SamarGrigoriy/simistor-regulator/images/01_плата_сверху.png

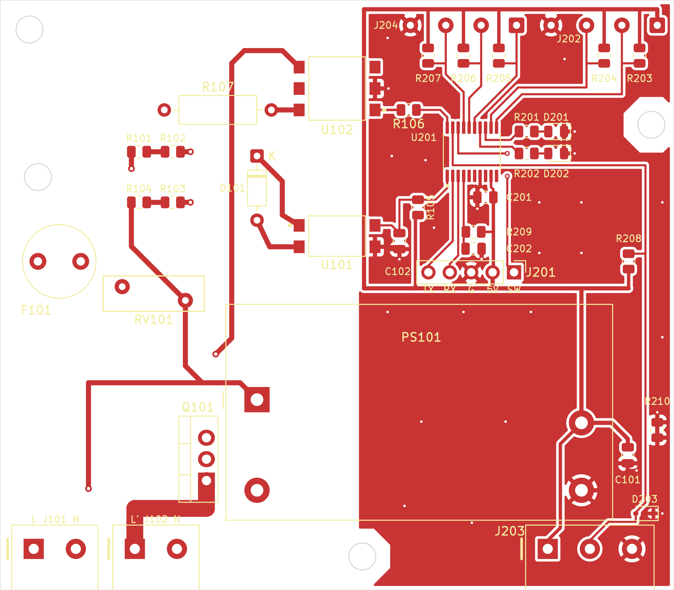
images/01_плата_сверху.png
