SamarGrigoriy/simistor-regulator/images/02_плата_снизу.png

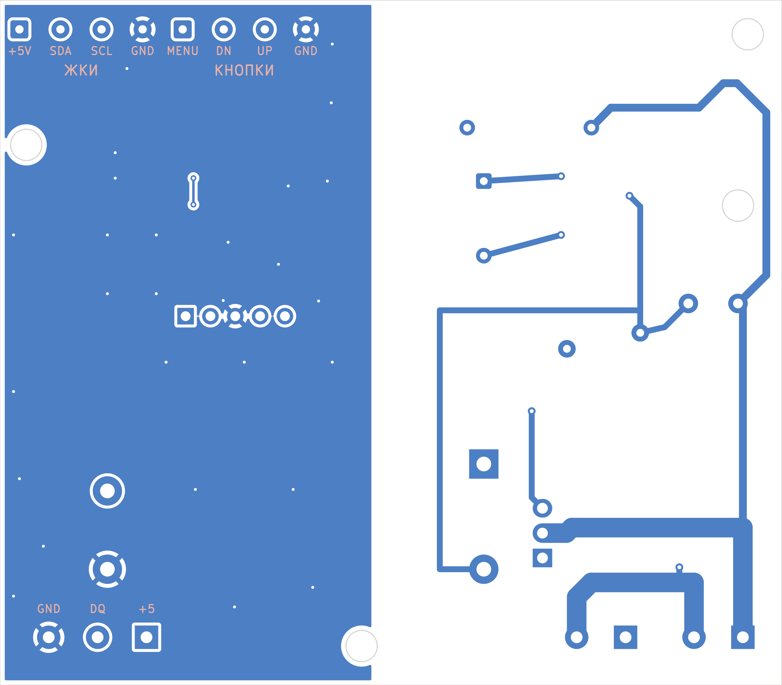
images/02_плата_снизу.png
