SamarGrigoriy/simistor-regulator/images/04_медь_B.png

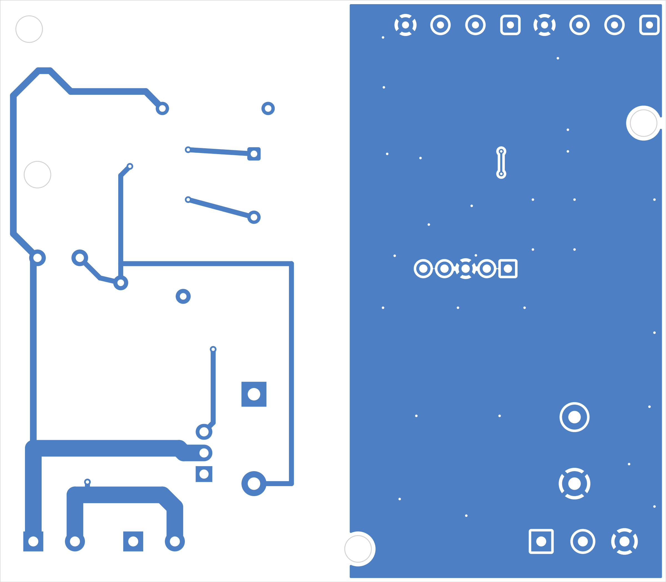
images/04_медь_B.png
