SamarGrigoriy/simistor-regulator/images/05_сборочный.png

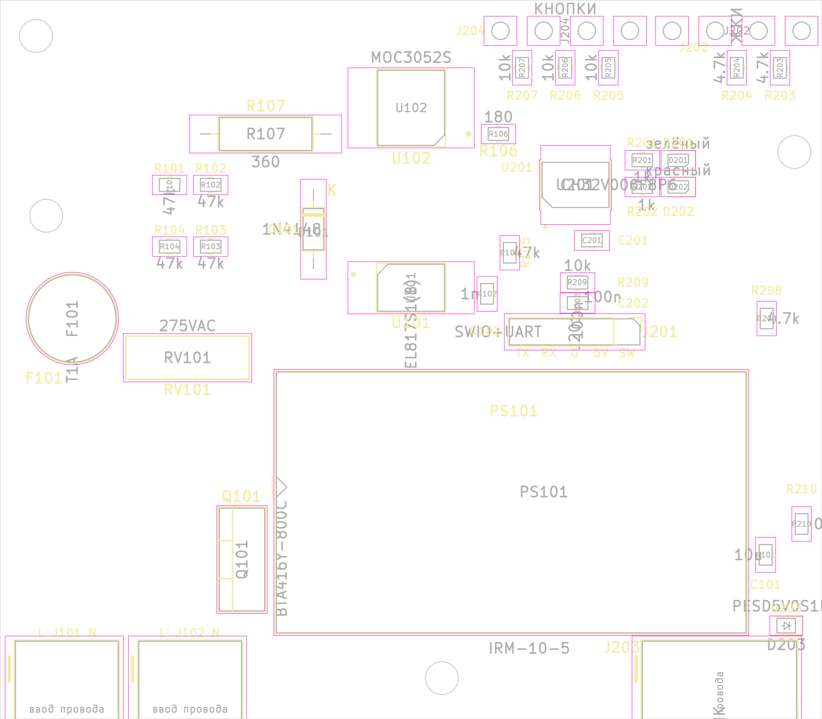
images/05_сборочный.png
