SamarGrigoriy/simistor-regulator/images/06_3d_сверху.png

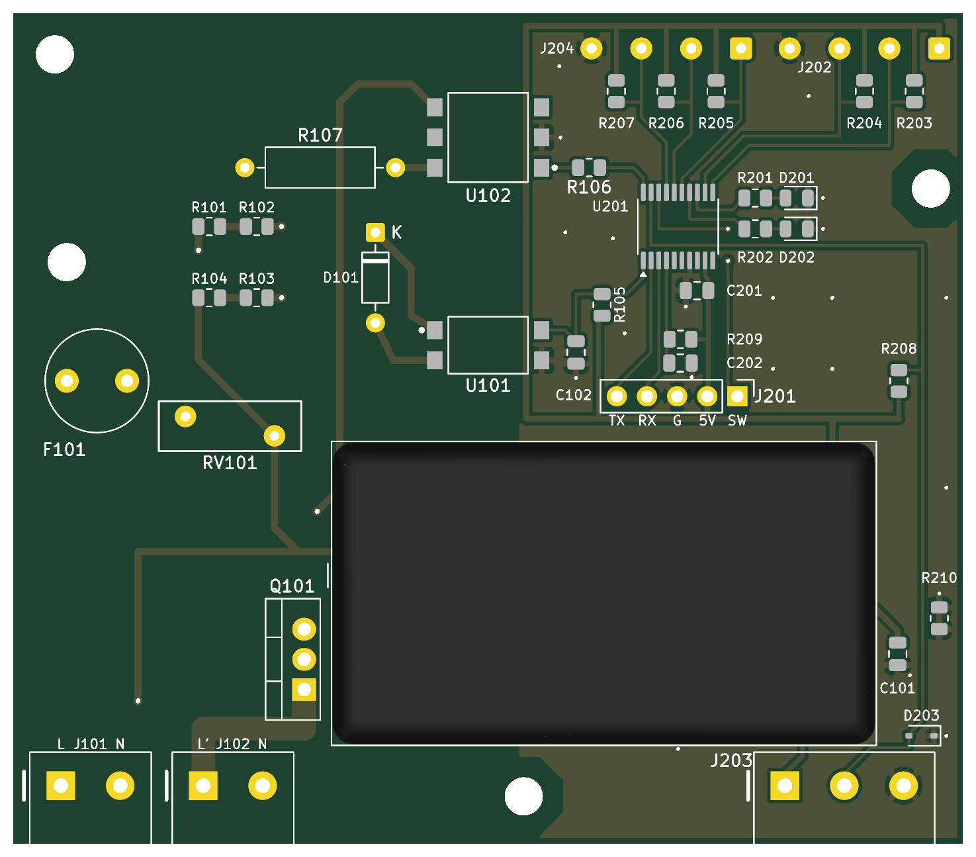
images/06_3d_сверху.png
