SamarGrigoriy/simistor-regulator/images/07_3d_изометрия.png

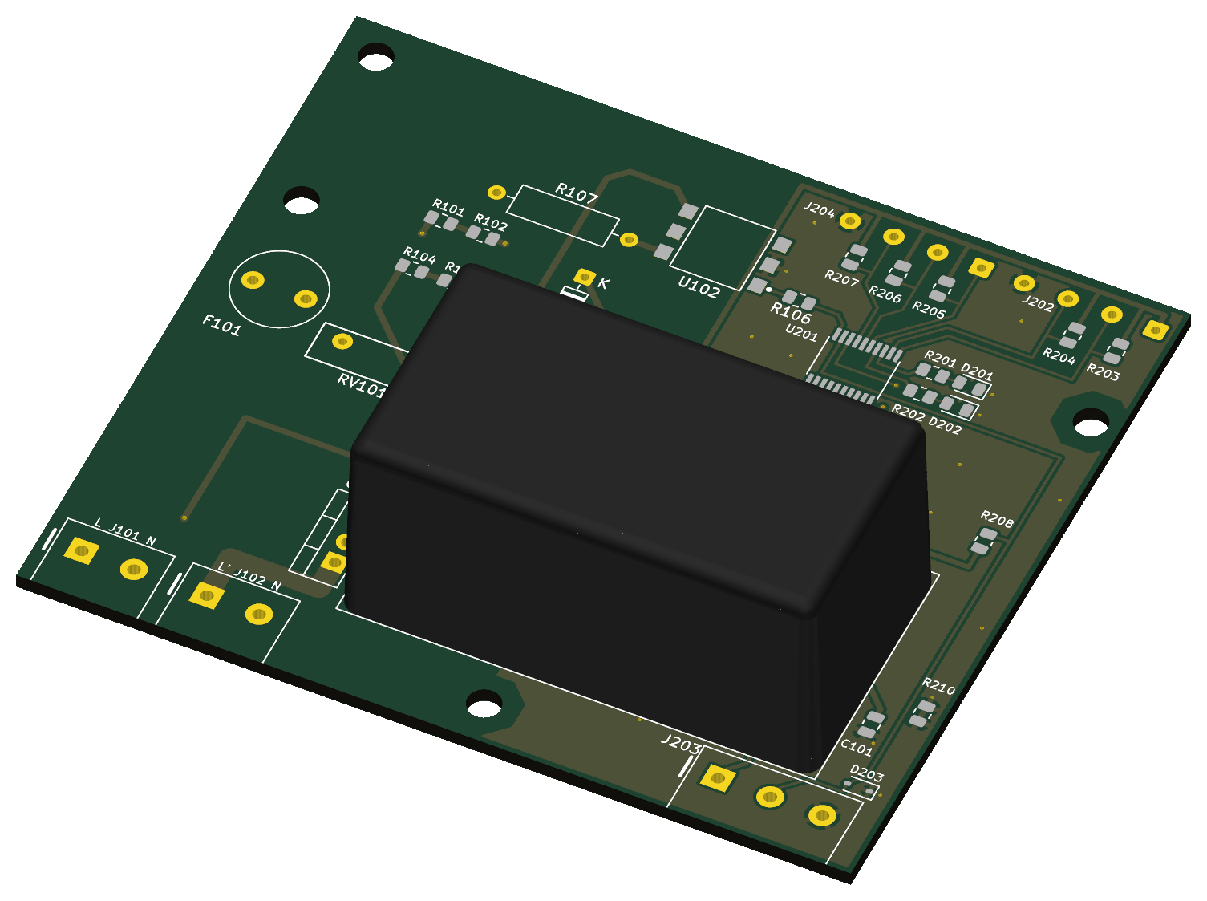
images/07_3d_изометрия.png
