SamarGrigoriy/simistor-regulator/images/08_3d_снизу.png

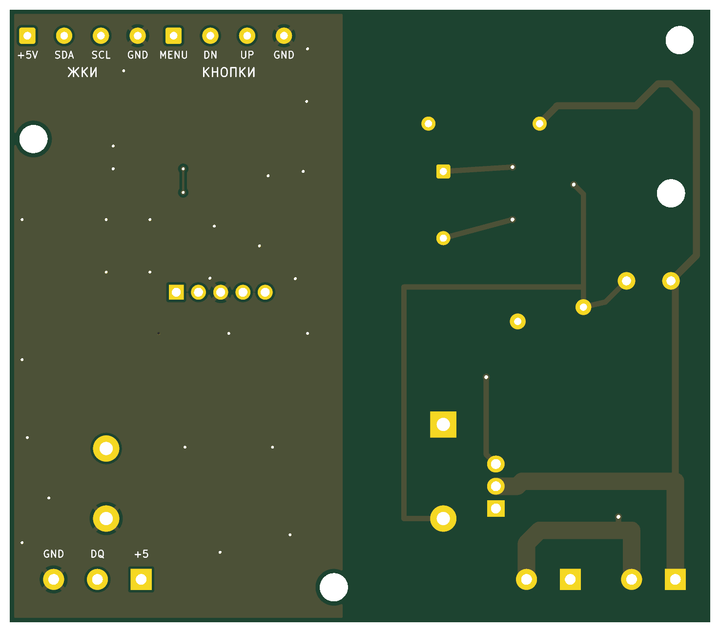
images/08_3d_снизу.png
