SamarGrigoriy/simistor-regulator/images/09_корпус.png

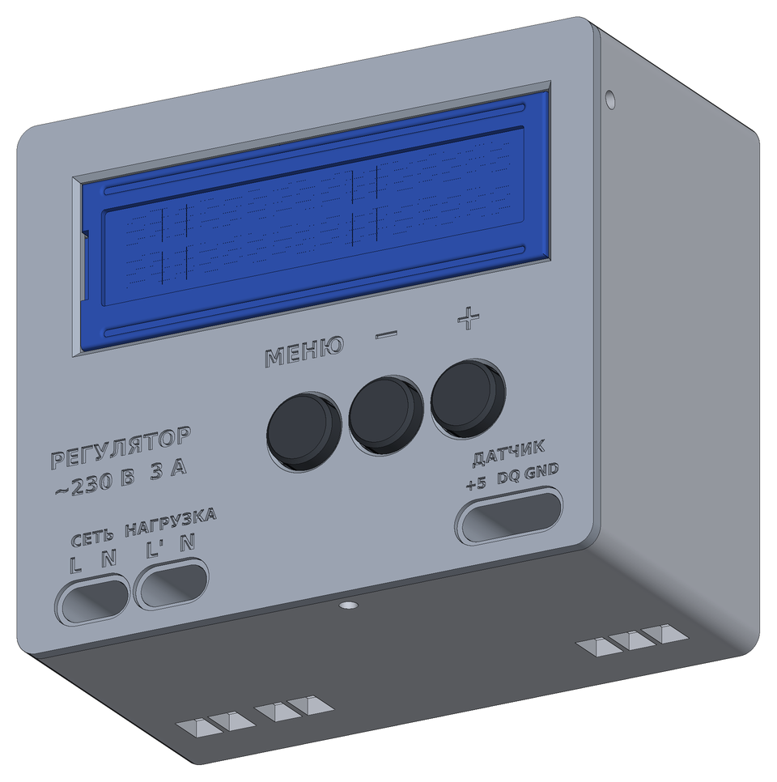
images/09_корпус.png
