SamarGrigoriy/simistor-regulator/images/10_корпус_лицо.png

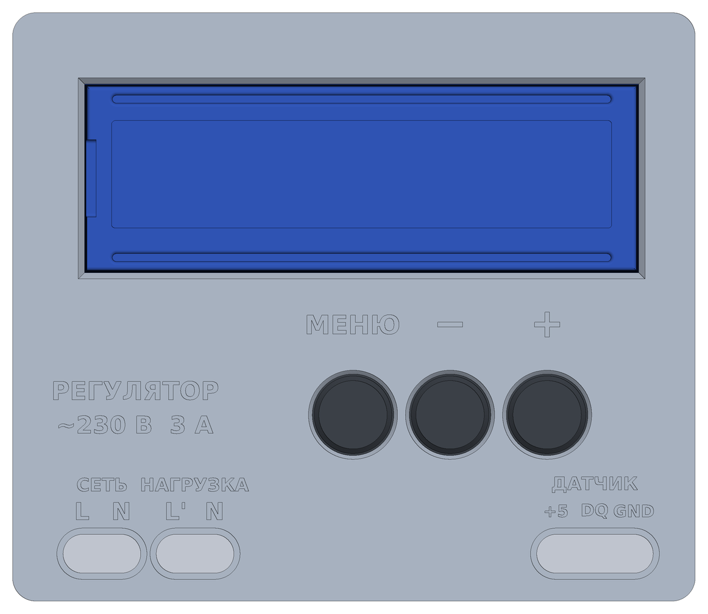
images/10_корпус_лицо.png
