SamarGrigoriy/simistor-regulator/images/11_корпус_сверху_слева.png

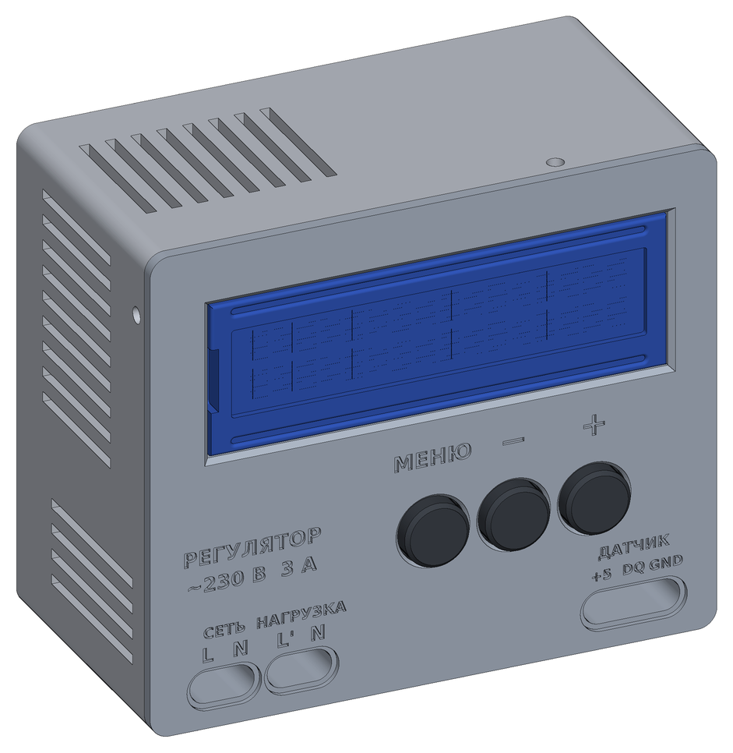
images/11_корпус_сверху_слева.png
