SamarGrigoriy/simistor-regulator/images/12_корпус_низ.png

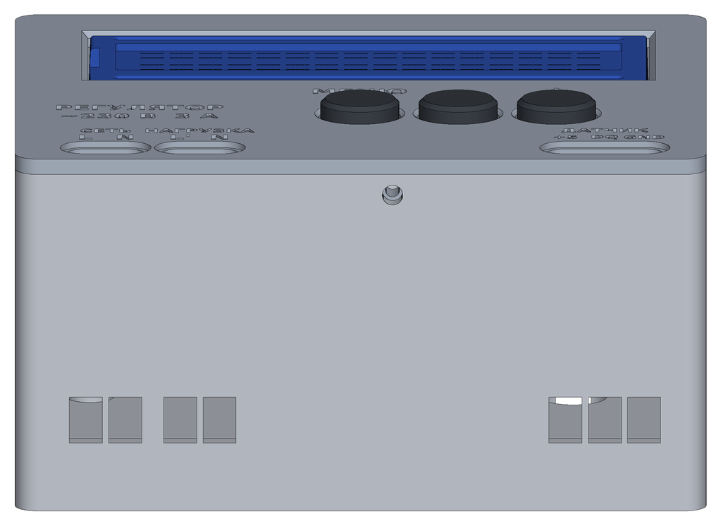
images/12_корпус_низ.png
