SamarGrigoriy/simistor-regulator/images/13_корпус_левая_стенка.png

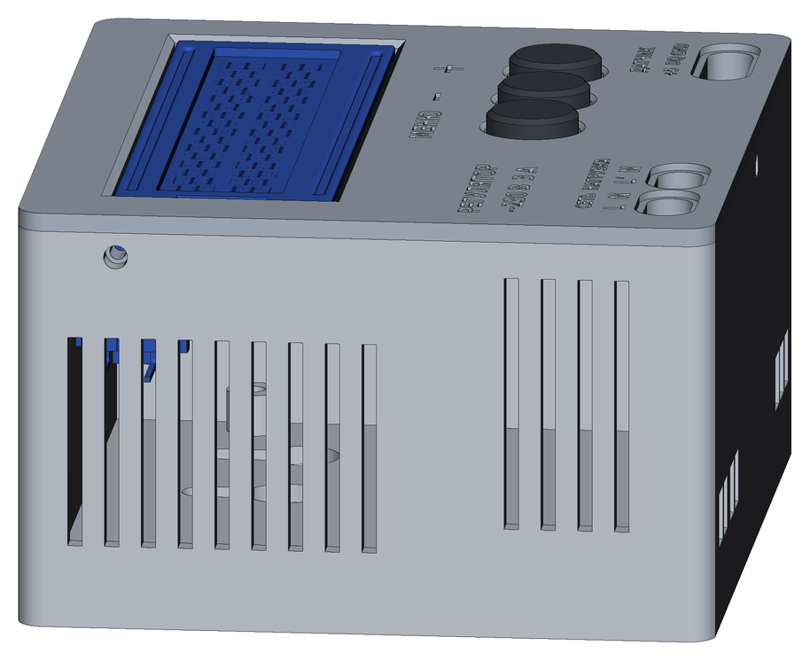
images/13_корпус_левая_стенка.png
