SamarGrigoriy/simistor-regulator/images/14_крышка_изнутри.png

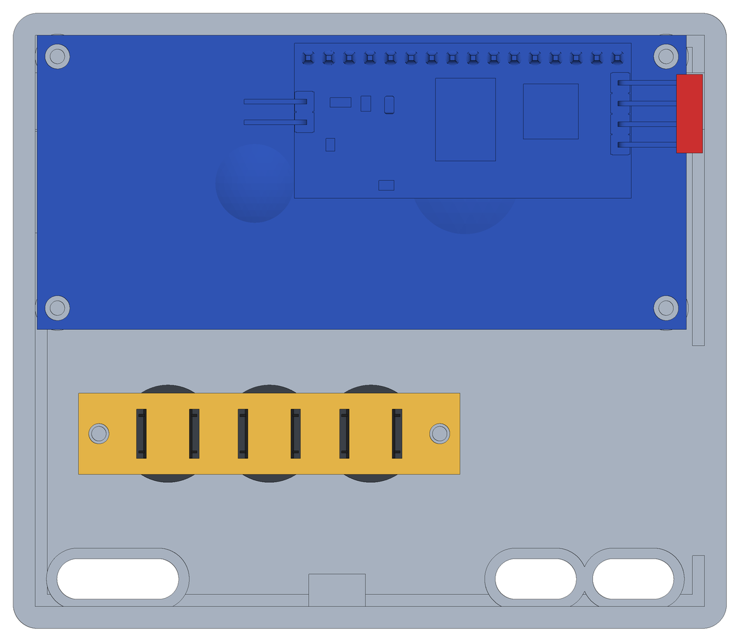
images/14_крышка_изнутри.png
