SamarGrigoriy/simistor-regulator/images/15_сборка_открыто.png

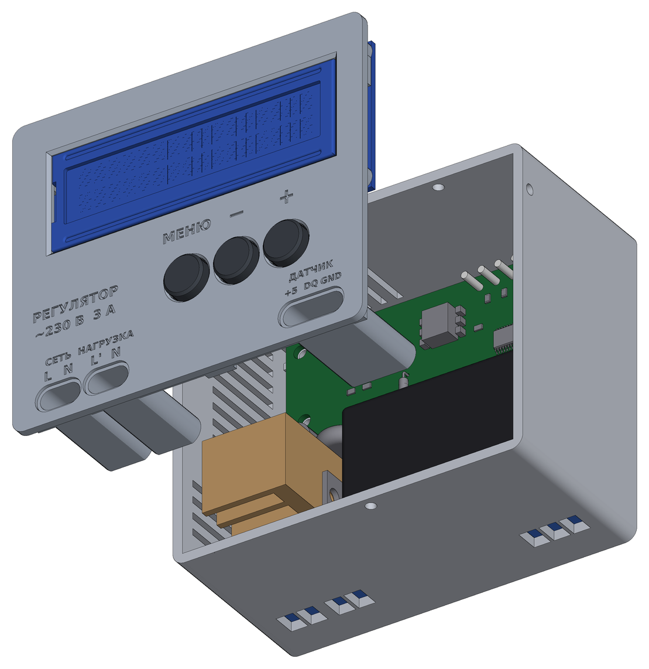
images/15_сборка_открыто.png
