SamarGrigoriy/simistor-regulator/images/16_сборка_внутри_сверху.png

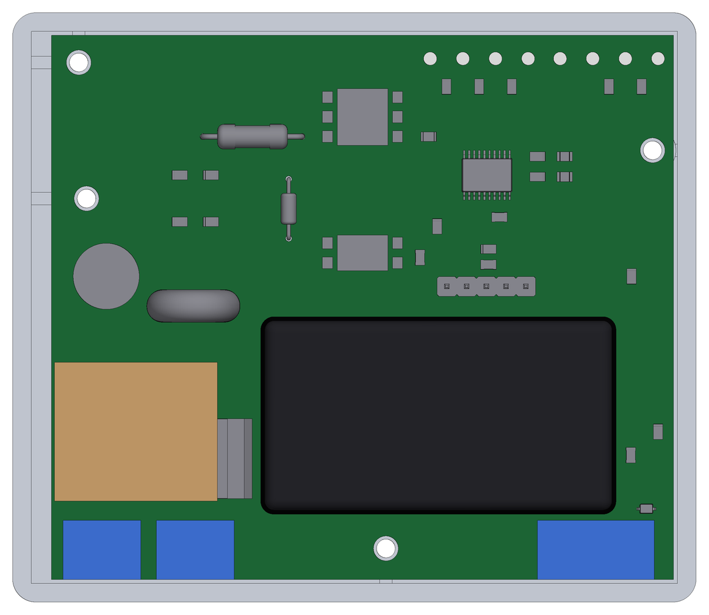
images/16_сборка_внутри_сверху.png
