SamarGrigoriy/simistor-regulator/images/17_сборка_внутри.png

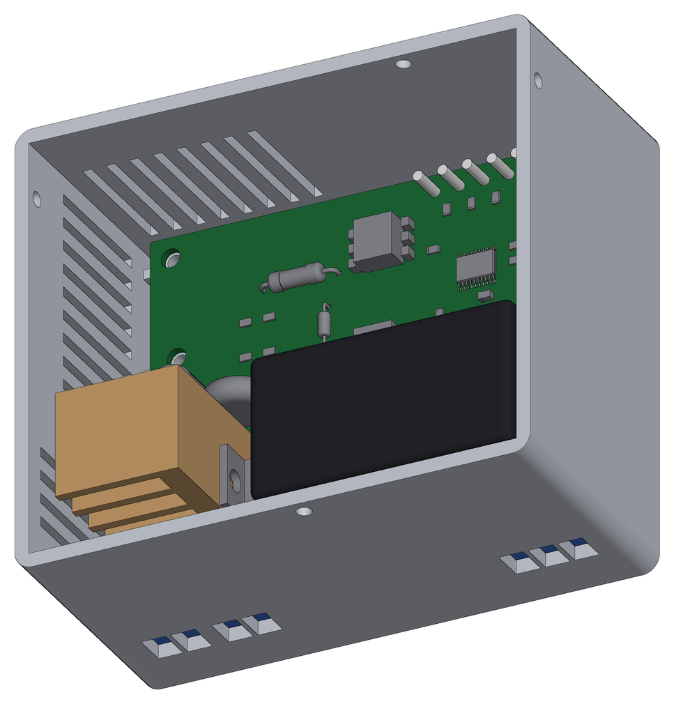
images/17_сборка_внутри.png
