SamarGrigoriy/simistor-regulator/images/18_взрыв_схема.png

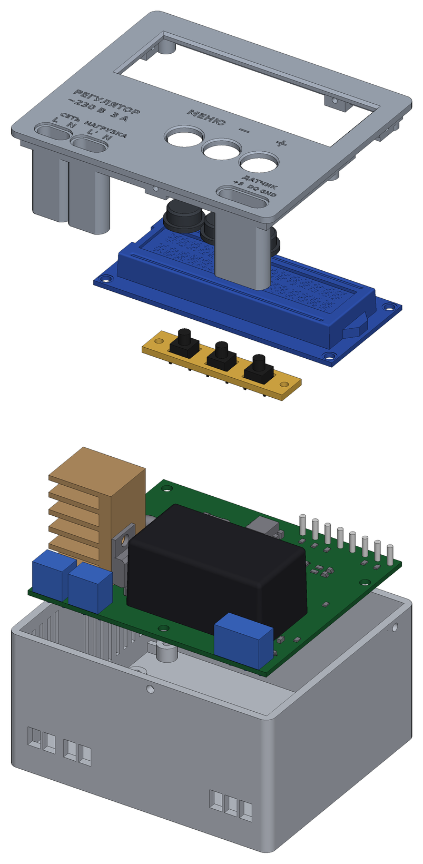
images/18_взрыв_схема.png
