SamarGrigoriy/simistor-regulator/images/19_разрез_ЖКИ.png

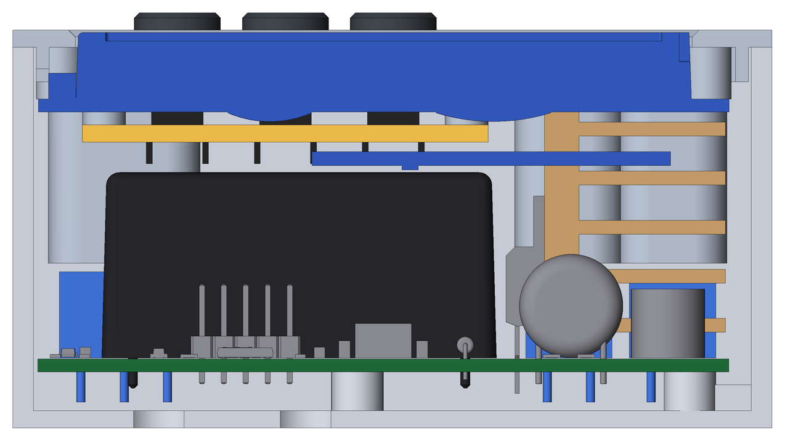
images/19_разрез_ЖКИ.png
