SamarGrigoriy/simistor-regulator/images/20_разрез_симистор.png

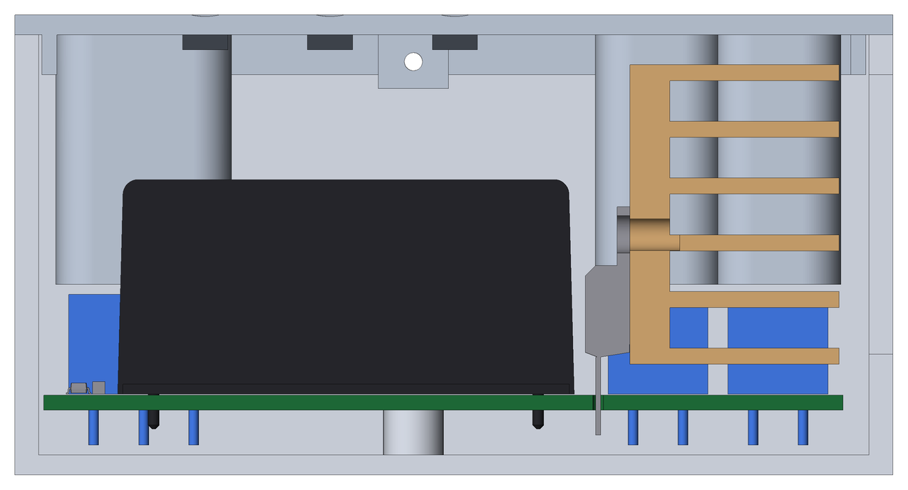
images/20_разрез_симистор.png
