SamarGrigoriy/simistor-regulator/images/src/3d_bottom.png

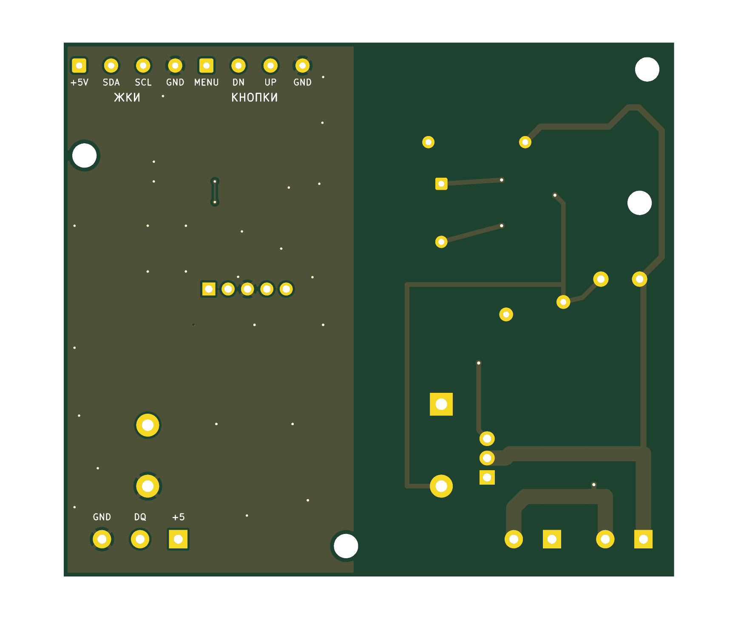
images/src/3d_bottom.png
