SamarGrigoriy/simistor-regulator/images/src/3d_iso.png

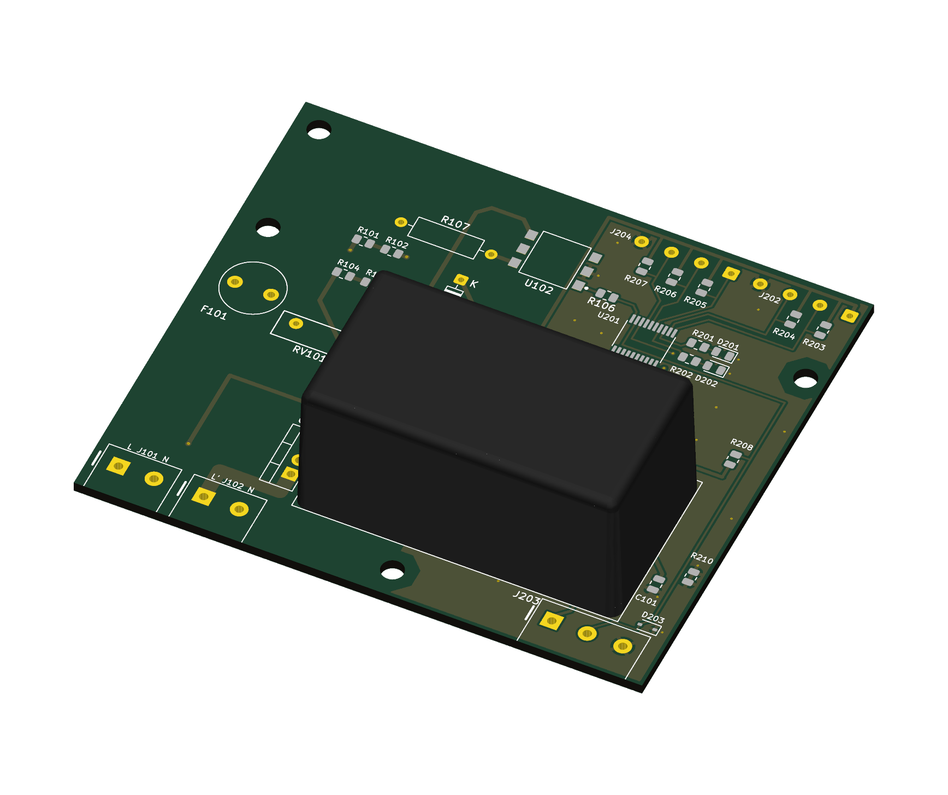
images/src/3d_iso.png
