SamarGrigoriy/simistor-regulator/images/src/3d_top.png

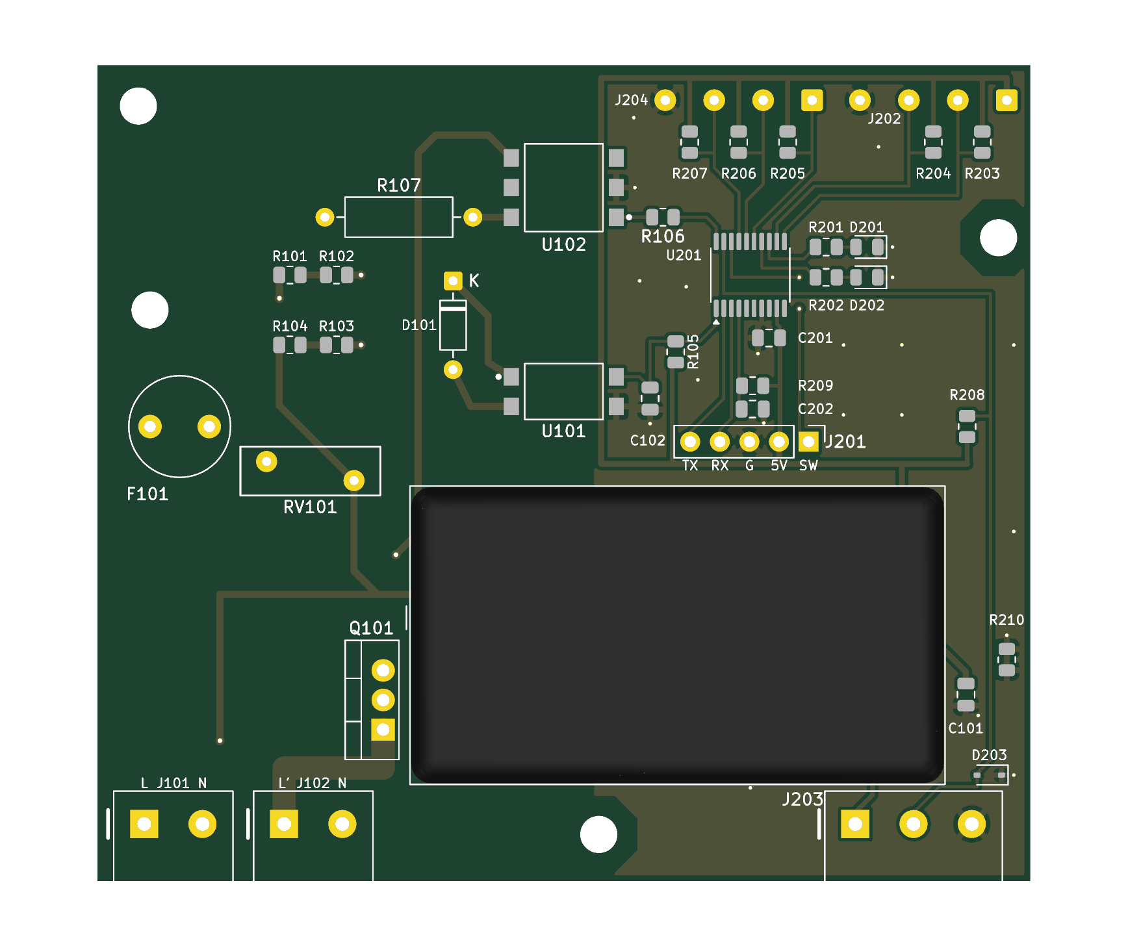
images/src/3d_top.png
