SamarGrigoriy/simistor-regulator/enclosure/build/assembly.step

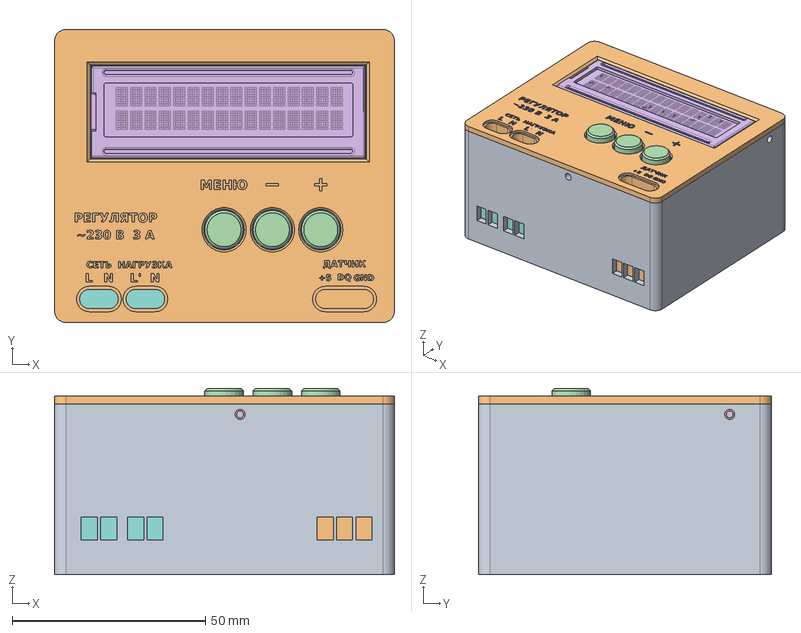
[picture p23: CAD file, 2026-10-23]
enclosure/build/assembly.step
87.9 x 75.8 x 48.1 mm
base
lid
button_holder
button_cap_1
button_cap_2
button_cap_3
heatsink
lcd_i2c
i2c_wires
switch_1
switch_2
switch_3
board
