SamarGrigoriy/simistor-regulator/enclosure/build/lid.stl

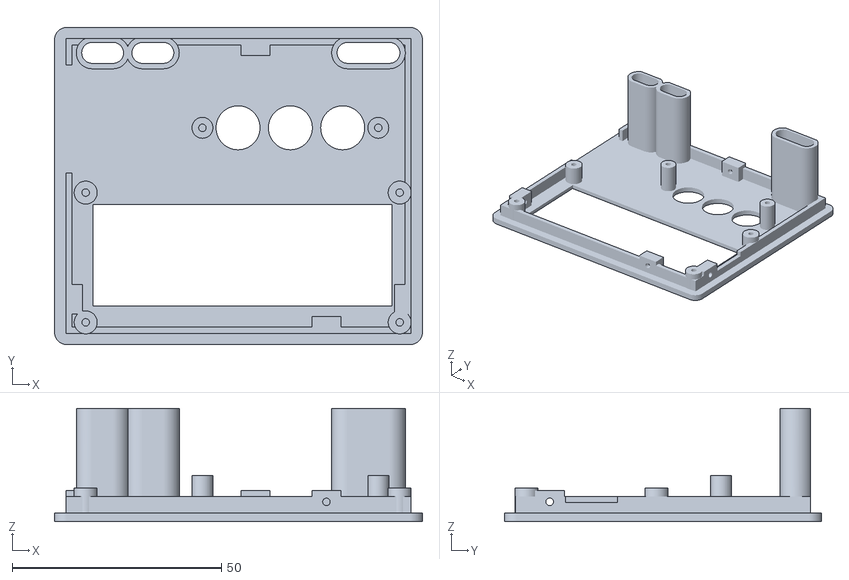
[picture p26: CAD file, 2026-10-23]
enclosure/build/lid.stl
87.9 x 75.8 x 27.0
