SamarGrigoriy/simistor-regulator/enclosure/build_4A/board.step

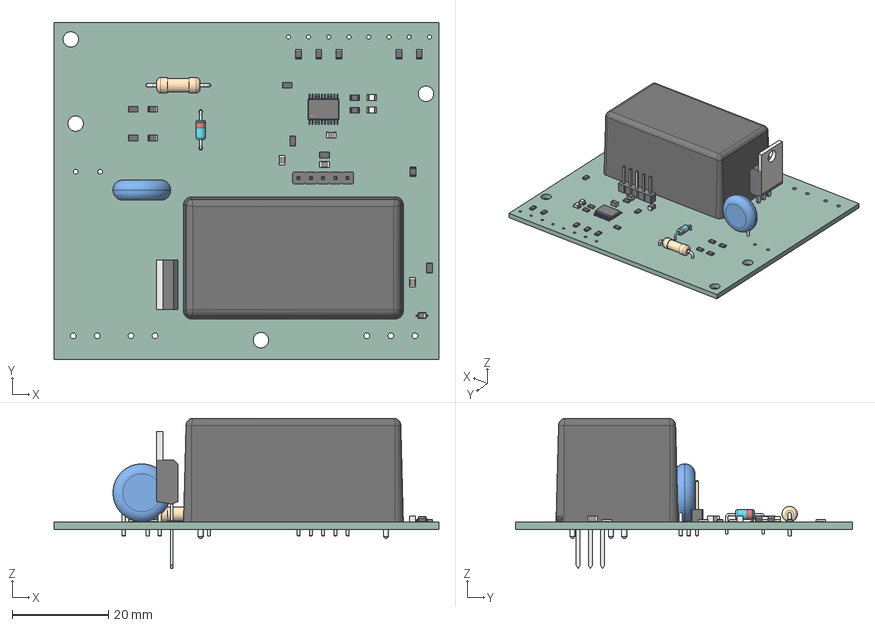
[picture p27: CAD file, 2026-10-23]
enclosure/build_4A/board.step
80.0 x 70.0 x 31.2 mm
R_0805_2012Metric x 16
C_0805_2012Metric x 4
LED_0805_2012Metric x 2
PinHeader_1x05_P254mm_Vertical
D_SOD-323
D_DO-35_SOD27_P7.62mm_Horizontal
TSSOP-20_4.4x6.5mm_P0.65mm
TO-220-3_Vertical
R_Axial_DIN0309_L90mm_D32mm_P1270mm_Horizontal
RV_Disc_D12mm_W42mm_P75mm
regulator1_PCB
