SamarGrigoriy/simistor-regulator/enclosure/models/LCD1602_I2C.step

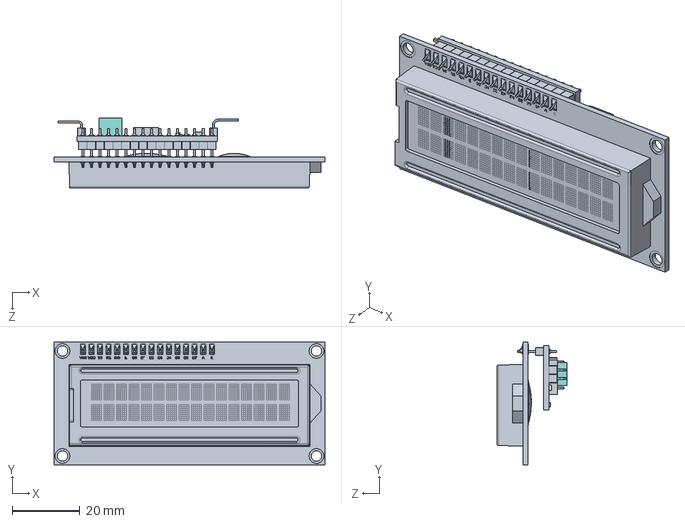
[picture p28: CAD file, 2026-10-23]
enclosure/models/LCD1602_I2C.step
80.0 x 36.3 x 20.8 mm
