SamarGrigoriy/simistor-regulator/enclosure/build/button_cap.stl

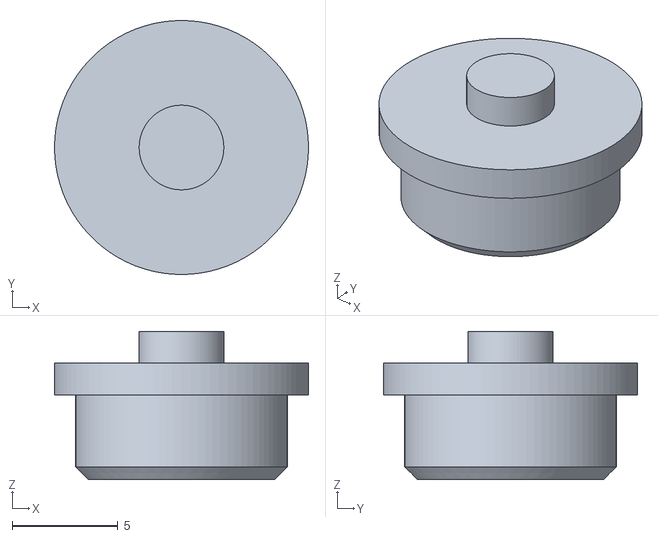
[picture p29: CAD file, 2026-10-23]
enclosure/build/button_cap.stl
12.0 x 12.0 x 7.00
