SamarGrigoriy/simistor-regulator/enclosure/build_4A/lid.stl

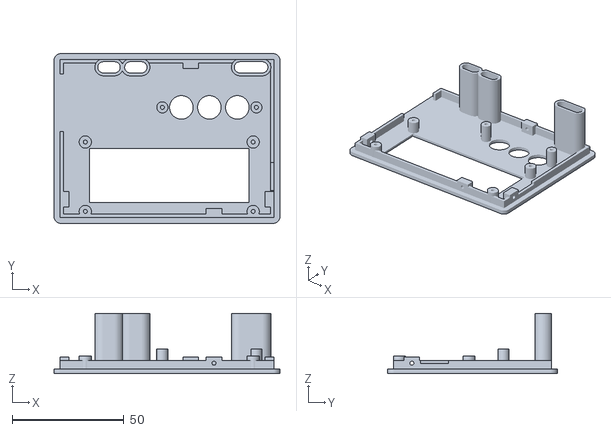
[picture p30: CAD file, 2026-10-23]
enclosure/build_4A/lid.stl
101.0 x 75.8 x 27.0
