SamarGrigoriy/simistor-regulator/enclosure/build/base.stl

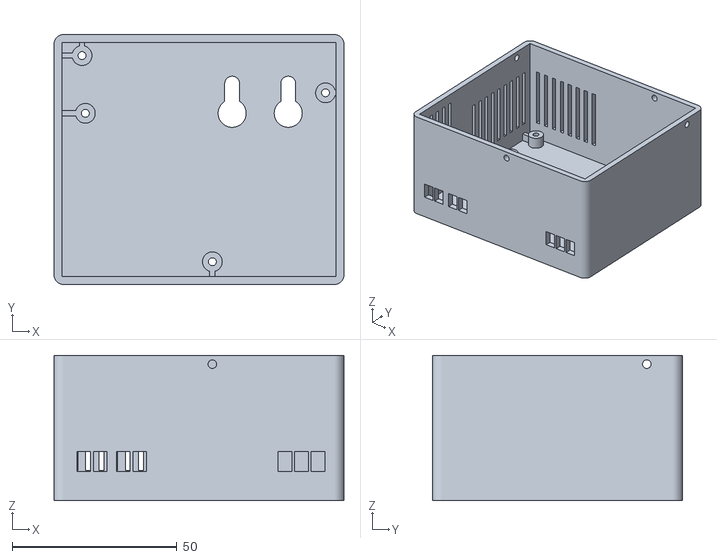
[picture p31: CAD file, 2026-10-23]
enclosure/build/base.stl
87.9 x 75.8 x 44.1
