SamarGrigoriy/simistor-regulator/enclosure/build_4A/button_holder.stl

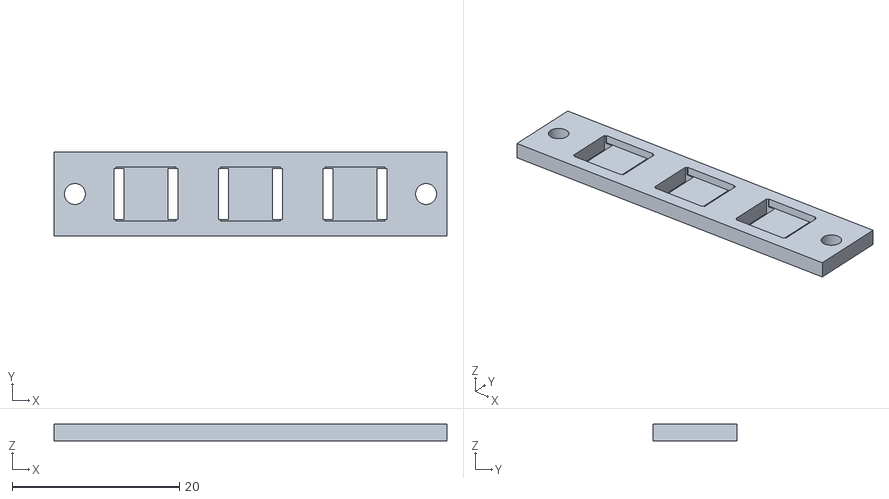
[picture p32: CAD file, 2026-10-23]
enclosure/build_4A/button_holder.stl
47.0 x 10.0 x 2.00
