SamarGrigoriy/simistor-regulator/enclosure/build_4A/case.step

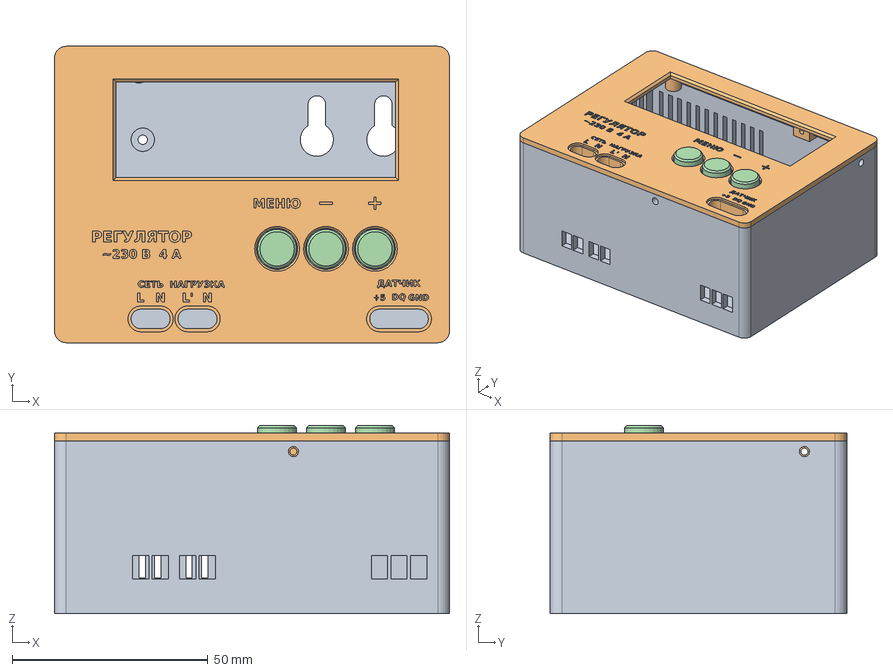
[picture p33: CAD file, 2026-10-23]
enclosure/build_4A/case.step
101.0 x 75.8 x 48.1 mm
base
lid
button_holder
button_cap_1
button_cap_2
button_cap_3
