SamarGrigoriy/simistor-regulator/enclosure/build_4A/base.stl

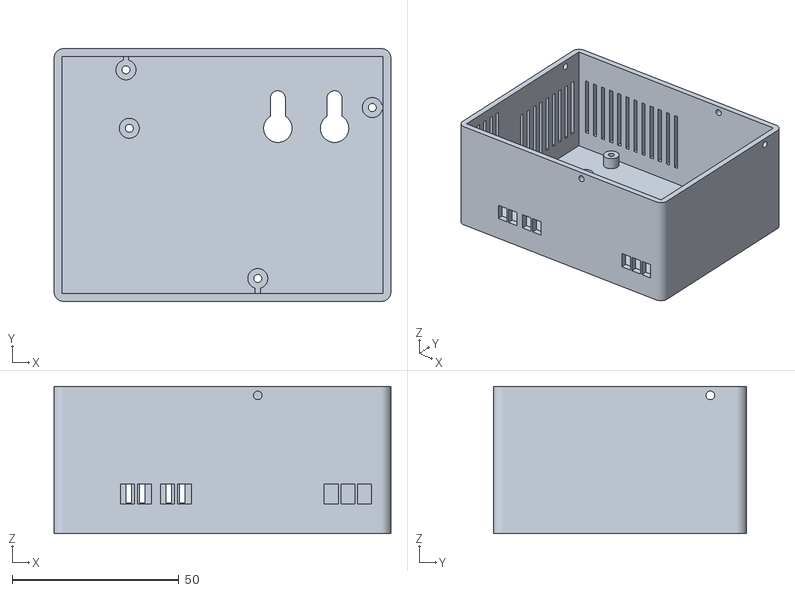
[picture p34: CAD file, 2026-10-23]
enclosure/build_4A/base.stl
101.0 x 75.8 x 44.1
