SamarGrigoriy/simistor-regulator/enclosure/build/case.step

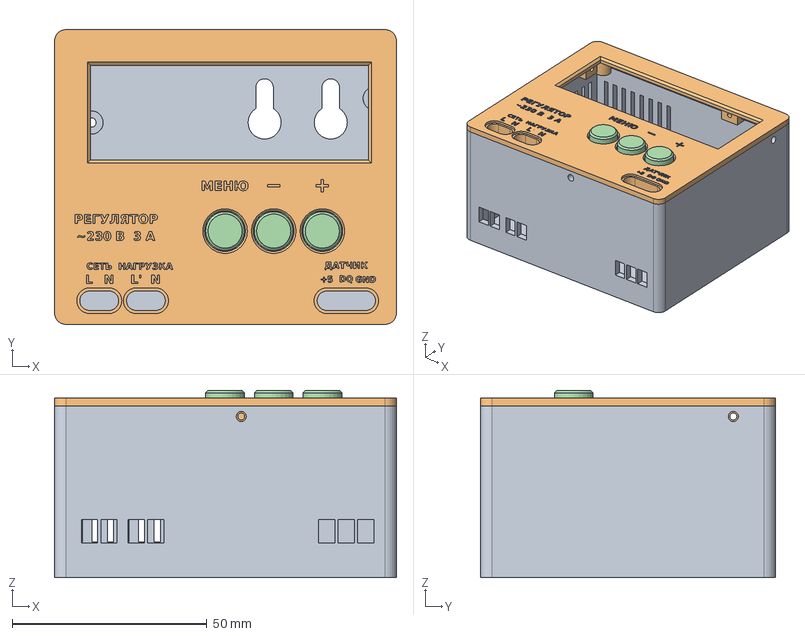
[picture p35: CAD file, 2026-10-23]
enclosure/build/case.step
87.9 x 75.8 x 48.1 mm
base
lid
button_holder
button_cap_1
button_cap_2
button_cap_3
