SamarGrigoriy/simistor-regulator/(list of files, cad)

Other CAD files:
enclosure/build/board.step
