SamarGrigoriy/simistor-regulator/build/3d_top.png

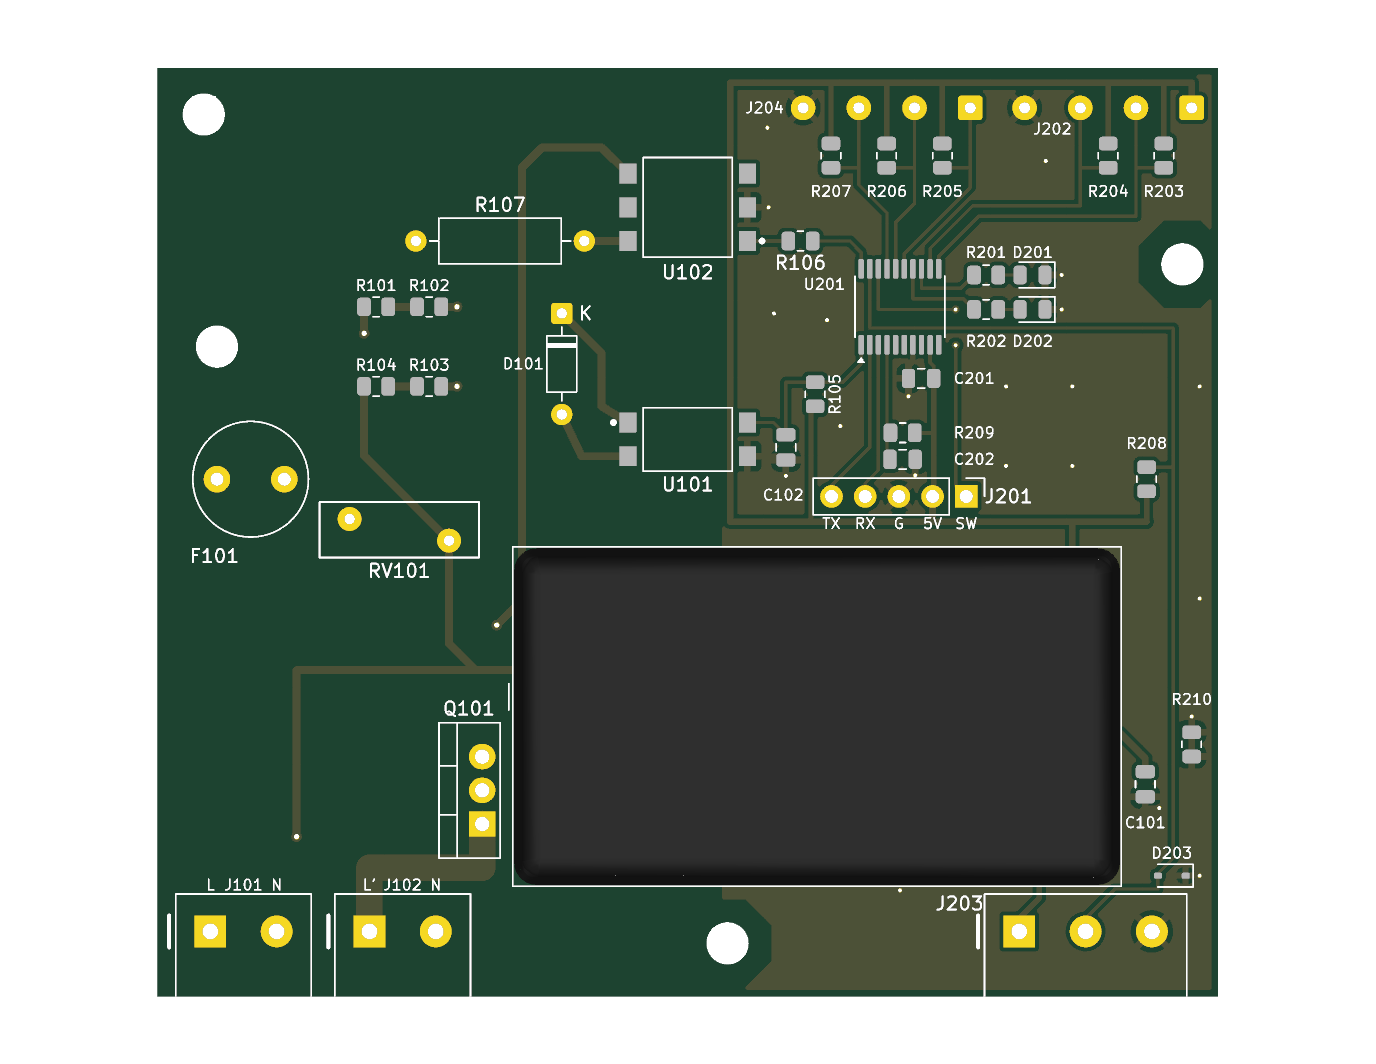
build/3d_top.png
