SamarGrigoriy/simistor-regulator/build/img/3d_bottom.png

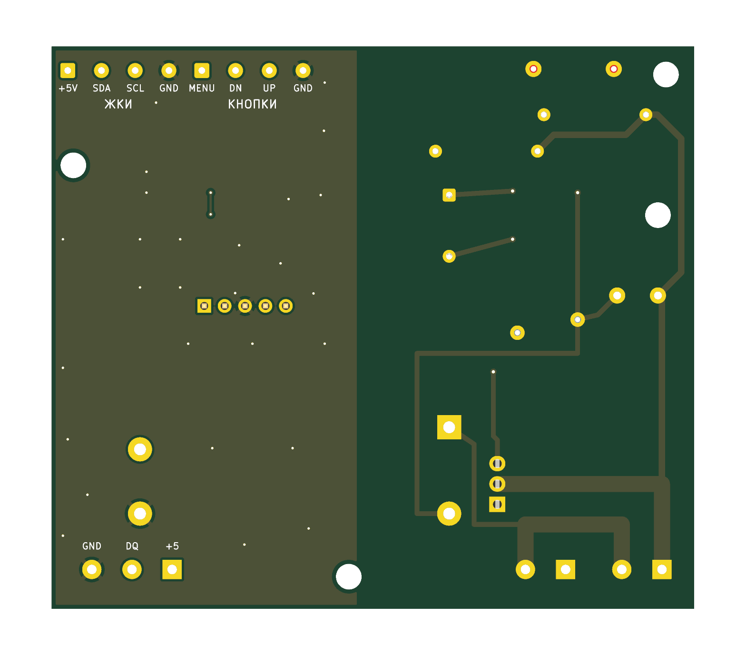
build/img/3d_bottom.png
