SamarGrigoriy/simistor-regulator/build/img/3d_iso.png

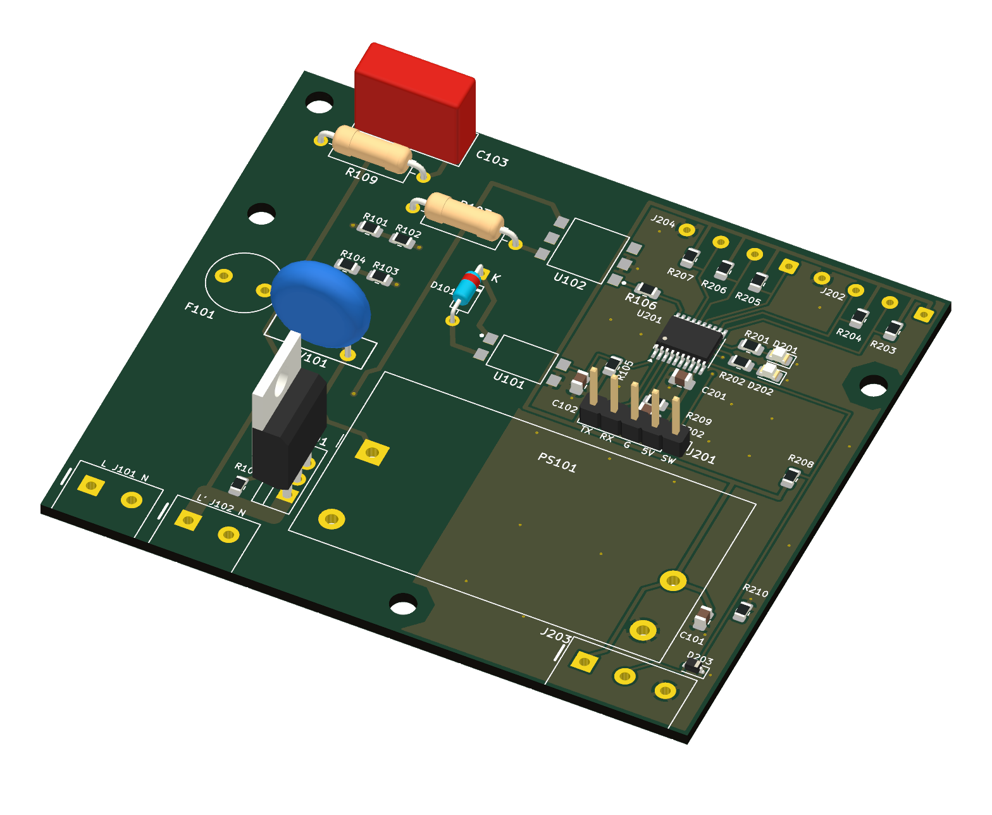
build/img/3d_iso.png
