SamarGrigoriy/simistor-regulator/build/img/3d_top.png

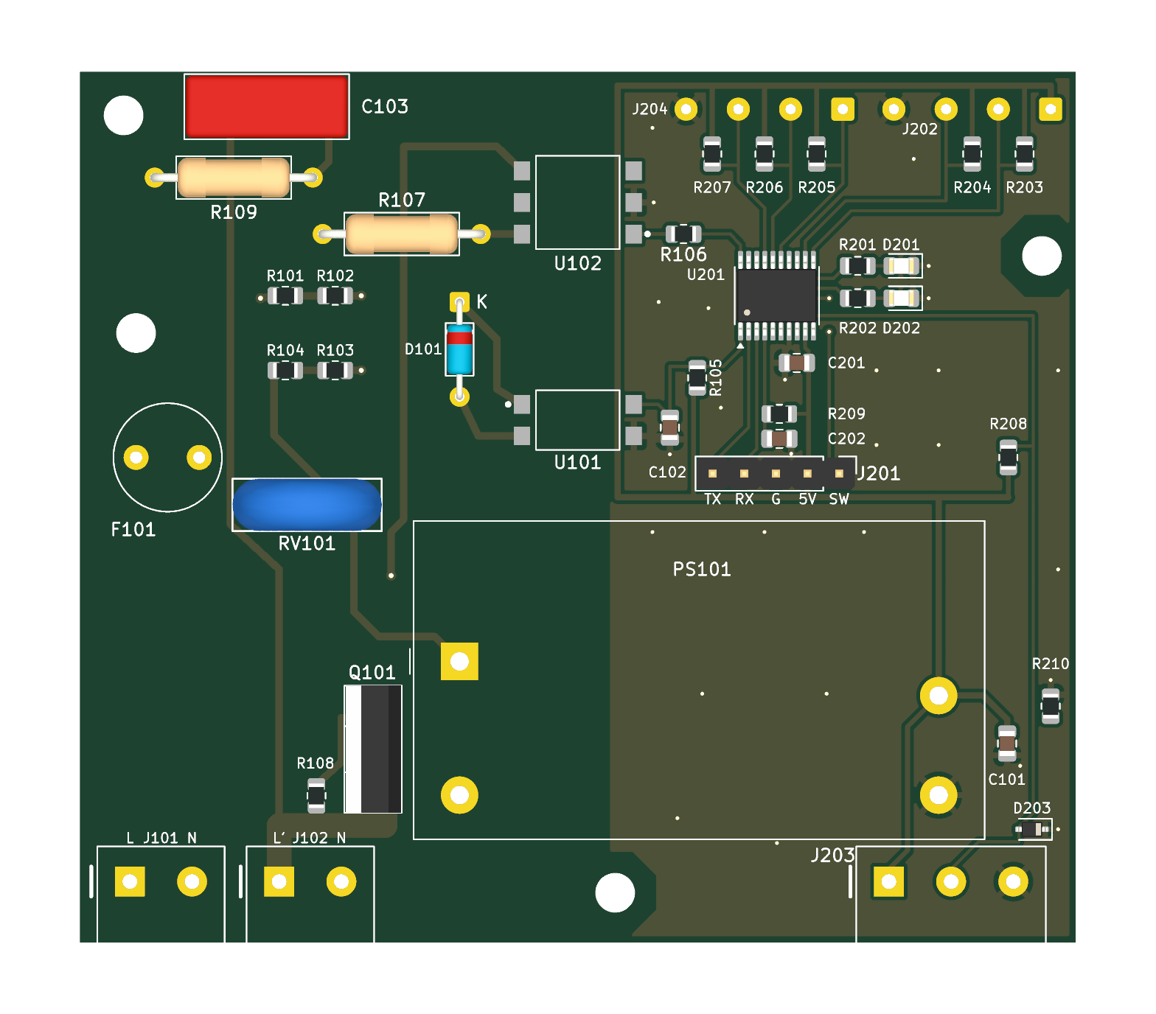
build/img/3d_top.png
