SamarGrigoriy/simistor-regulator/build/img/B_mains.png

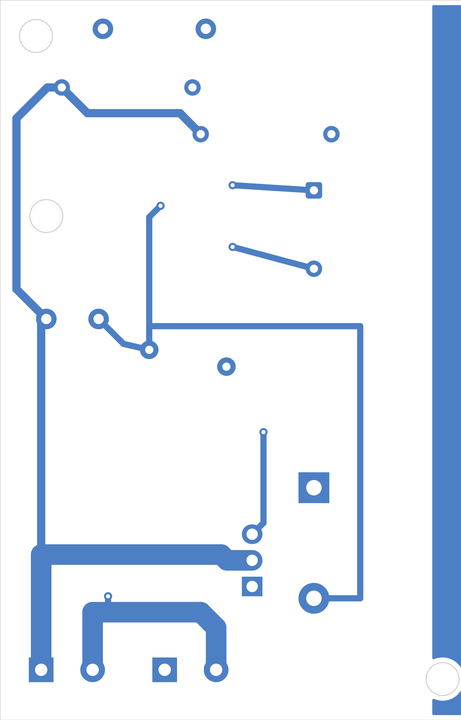
build/img/B_mains.png
