SamarGrigoriy/simistor-regulator/build/img/F.png

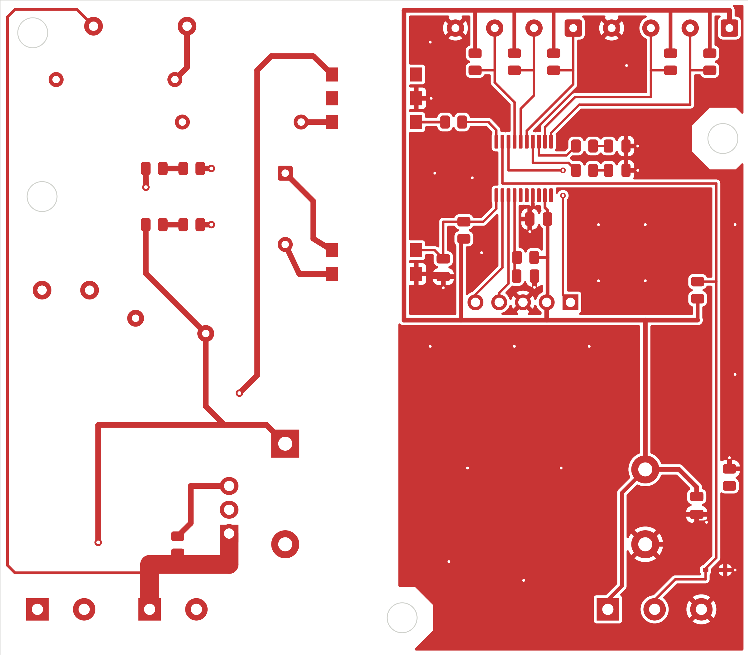
build/img/F.png
