SamarGrigoriy/simistor-regulator/build/img/f.png

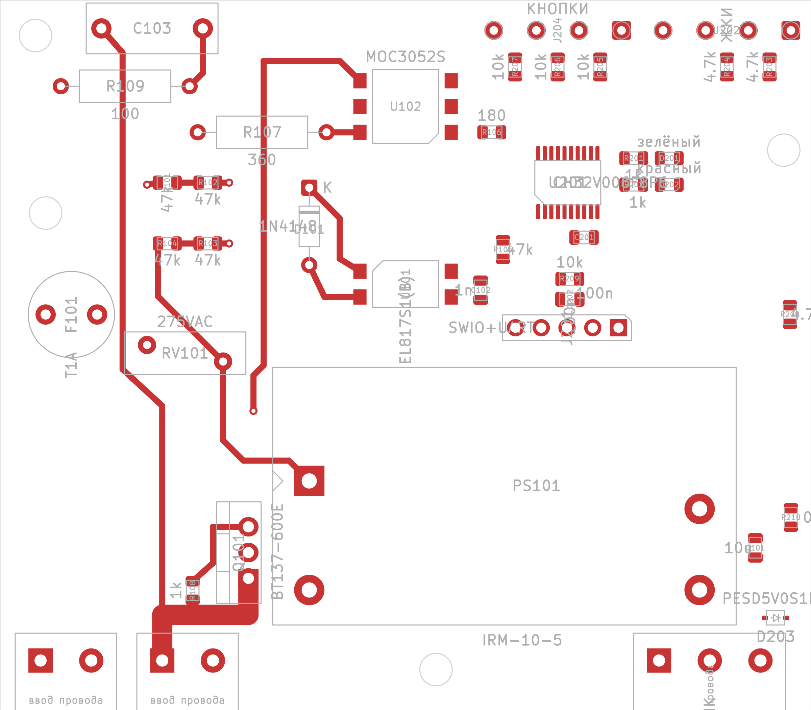
build/img/f.png
