SamarGrigoriy/simistor-regulator/build/img/F_mains.png

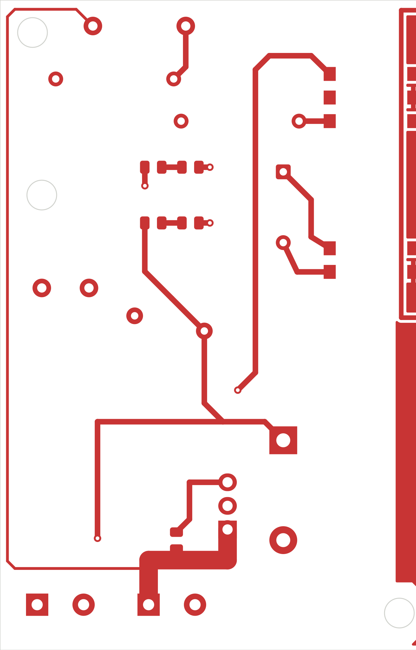
build/img/F_mains.png
