SamarGrigoriy/simistor-regulator/build/img/silk.png

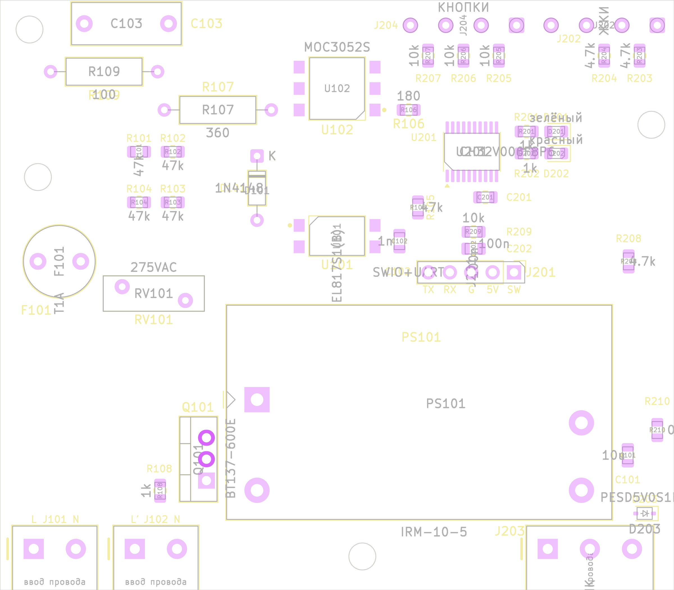
build/img/silk.png
