SamarGrigoriy/simistor-regulator/build/layers/F.SilkS.png

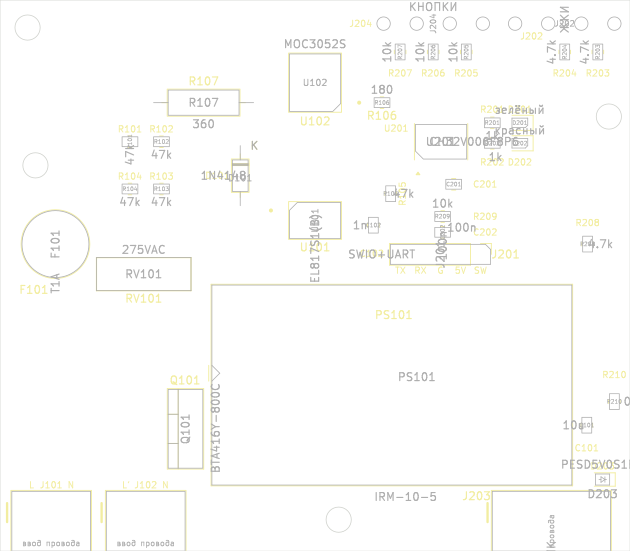
build/layers/F.SilkS.png
