SamarGrigoriy/simistor-regulator/build/place_top.png

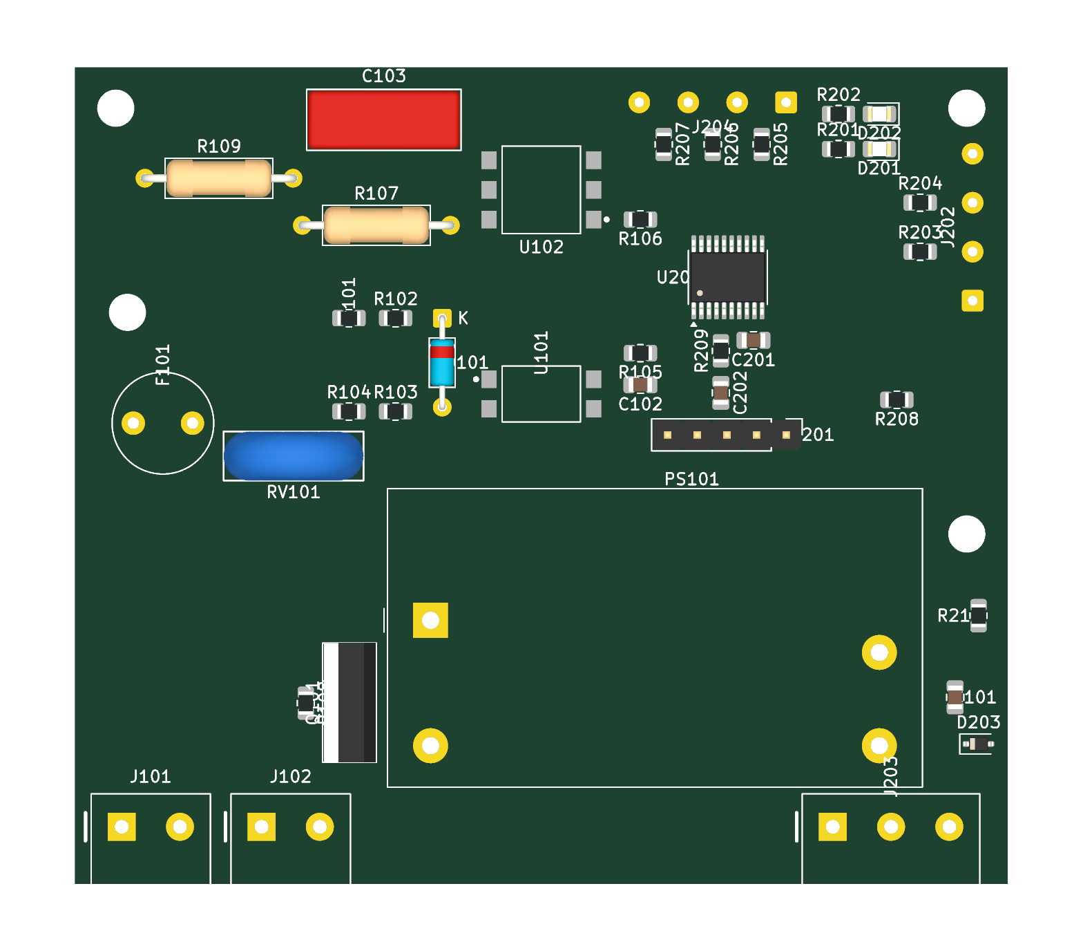
build/place_top.png
