SamarGrigoriy/simistor-regulator/enclosure/build/view_bottom_wall.png

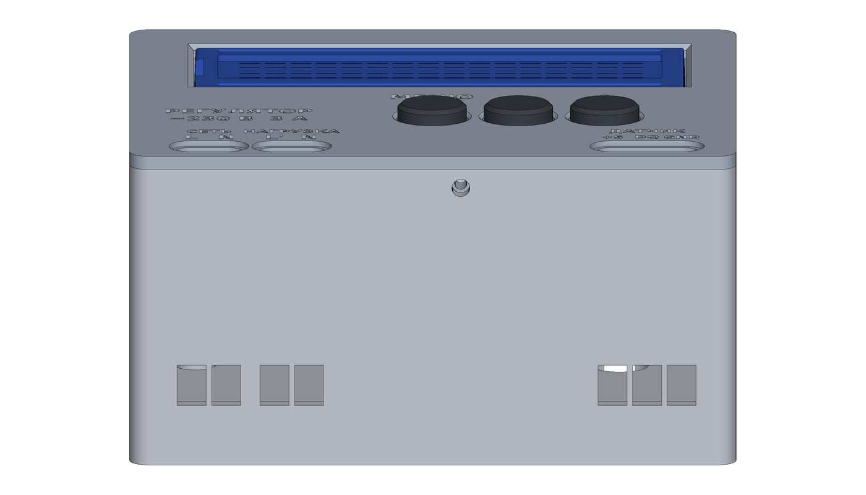
enclosure/build/view_bottom_wall.png
