SamarGrigoriy/simistor-regulator/enclosure/build/view_closed.png

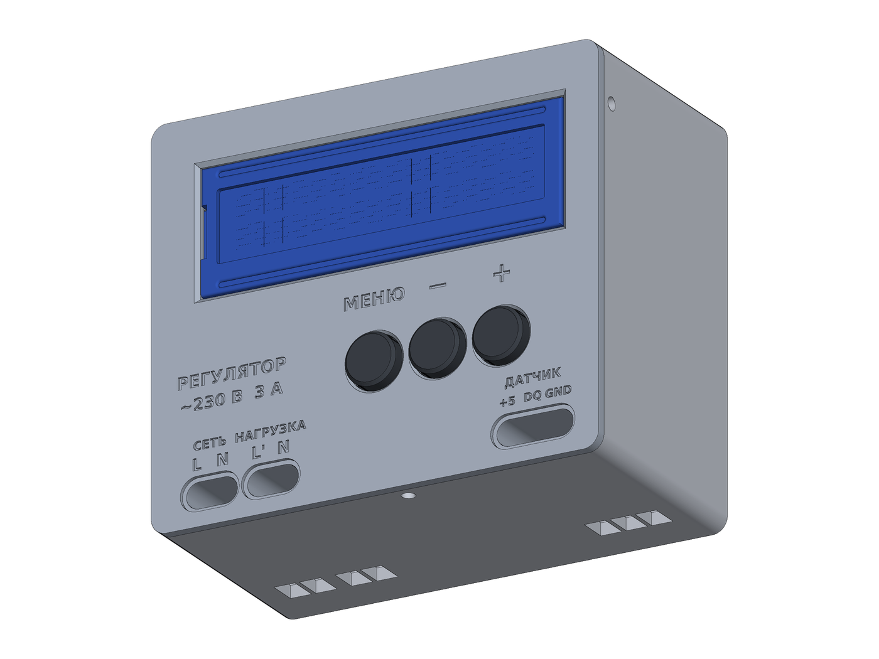
enclosure/build/view_closed.png
