SamarGrigoriy/simistor-regulator/enclosure/build/view_closed_above.png

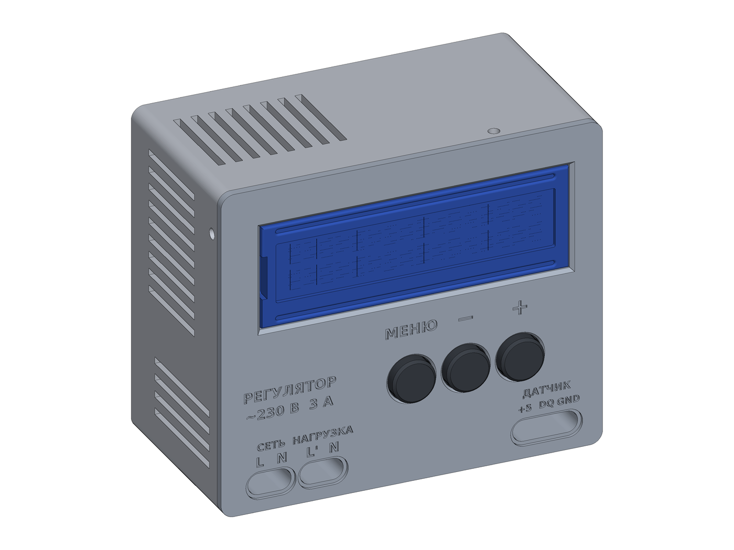
enclosure/build/view_closed_above.png
