SamarGrigoriy/simistor-regulator/enclosure/build/view_exploded.png

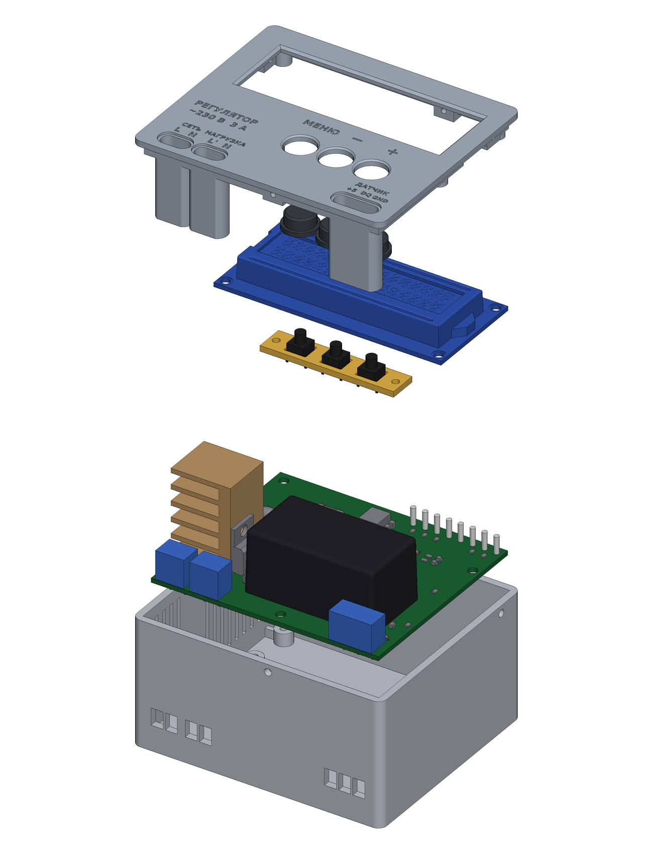
enclosure/build/view_exploded.png
