SamarGrigoriy/simistor-regulator/enclosure/build/view_front.png

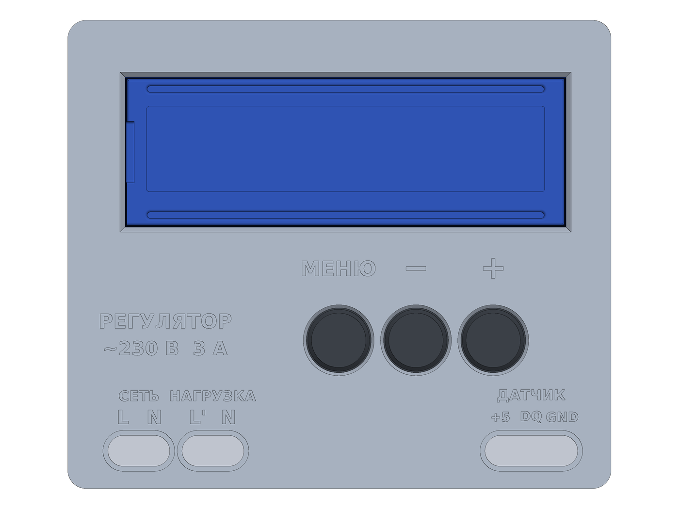
enclosure/build/view_front.png
