SamarGrigoriy/simistor-regulator/enclosure/build/view_inside_iso.png

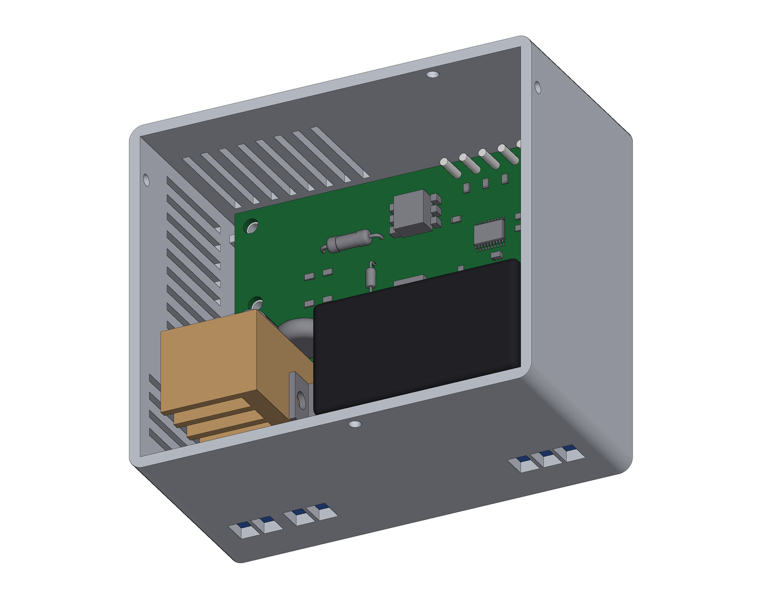
enclosure/build/view_inside_iso.png
