SamarGrigoriy/simistor-regulator/enclosure/build/view_inside_top.png

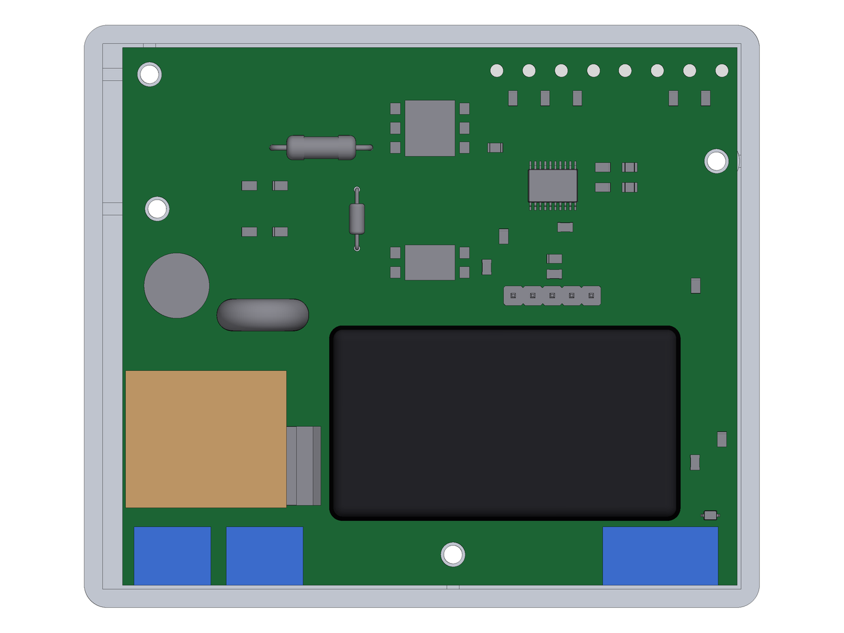
enclosure/build/view_inside_top.png
