SamarGrigoriy/simistor-regulator/enclosure/build/view_left_wall.png

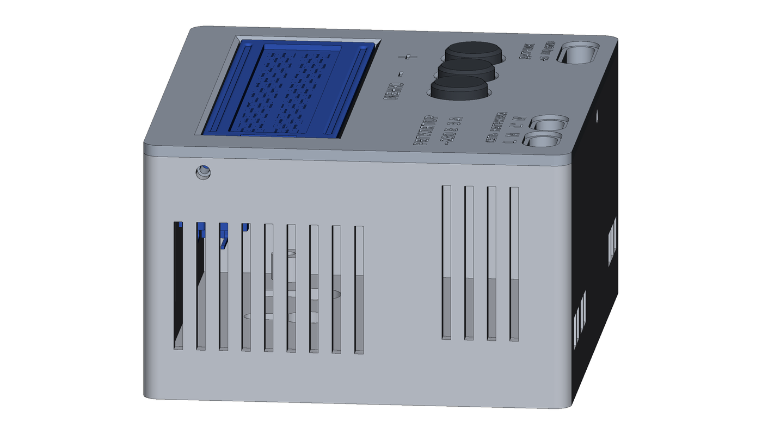
enclosure/build/view_left_wall.png
