SamarGrigoriy/simistor-regulator/enclosure/build/view_lid_inside.png

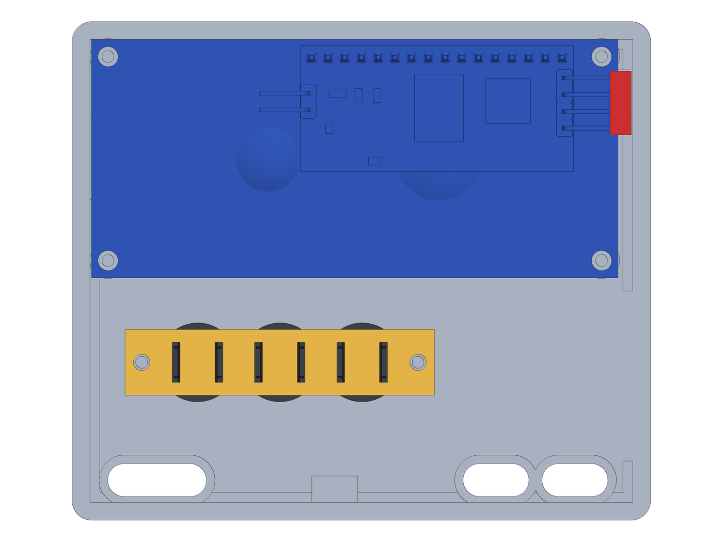
enclosure/build/view_lid_inside.png
