SamarGrigoriy/simistor-regulator/enclosure/build/view_open.png

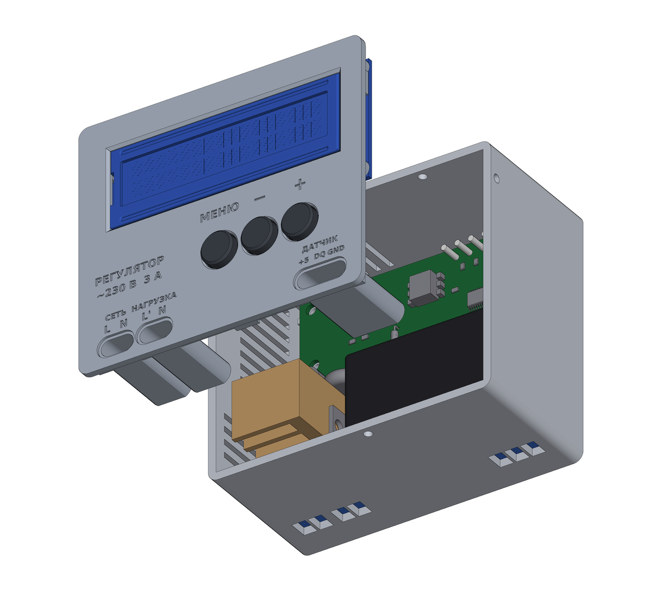
enclosure/build/view_open.png
