SamarGrigoriy/simistor-regulator/enclosure/build/view_section_lcd.png

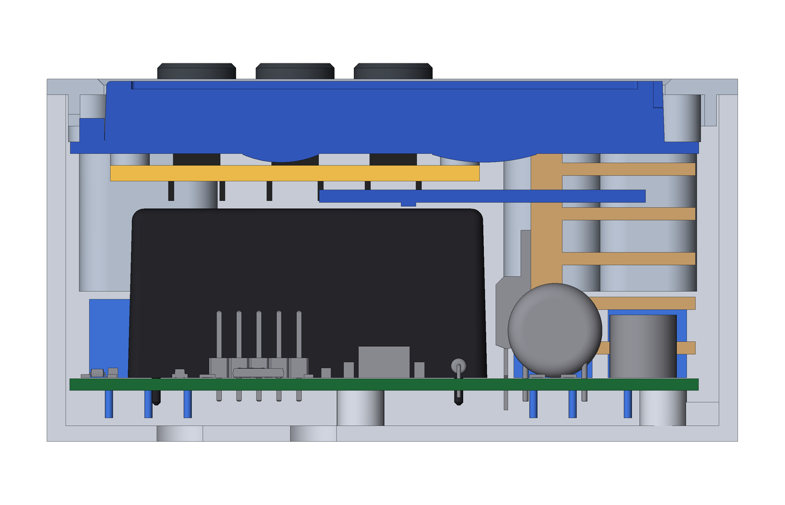
enclosure/build/view_section_lcd.png
