SamarGrigoriy/simistor-regulator/enclosure/build/view_section_triac.png

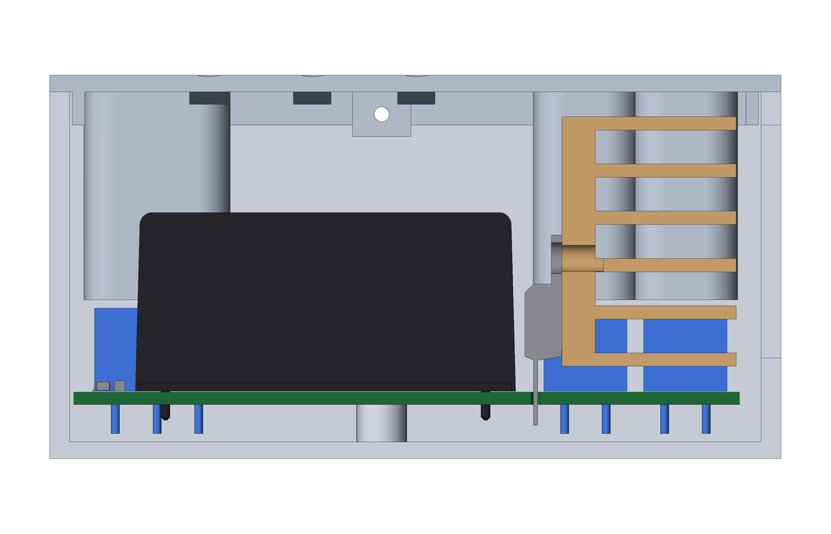
enclosure/build/view_section_triac.png
