SamarGrigoriy/simistor-regulator/enclosure/build_4A/view_bottom_wall.png

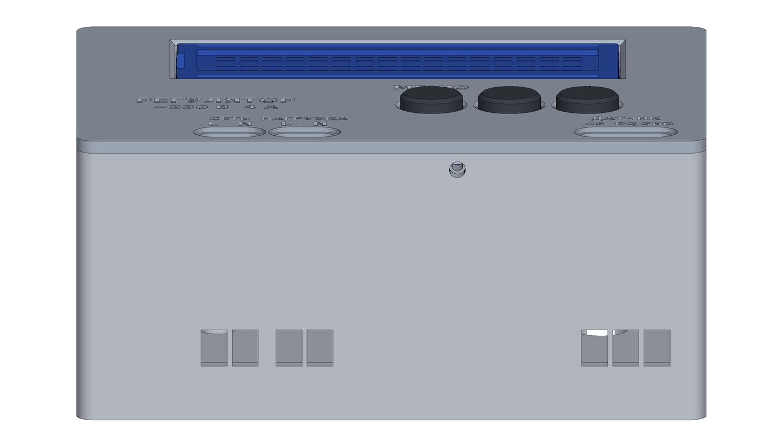
enclosure/build_4A/view_bottom_wall.png
