SamarGrigoriy/simistor-regulator/enclosure/build_4A/view_closed.png

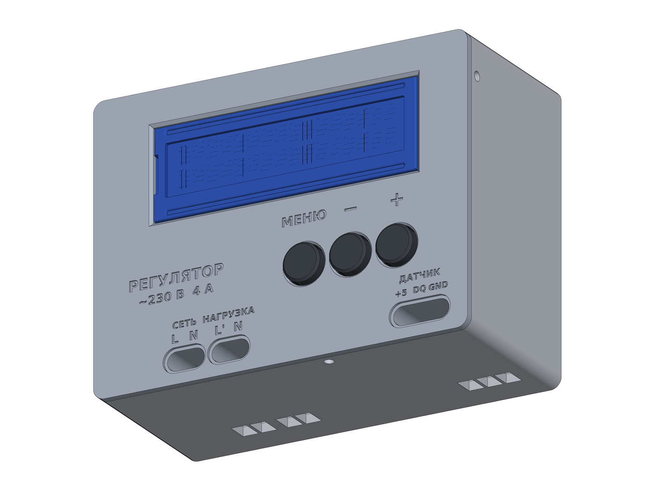
enclosure/build_4A/view_closed.png
