SamarGrigoriy/simistor-regulator/enclosure/build_4A/view_closed_above.png

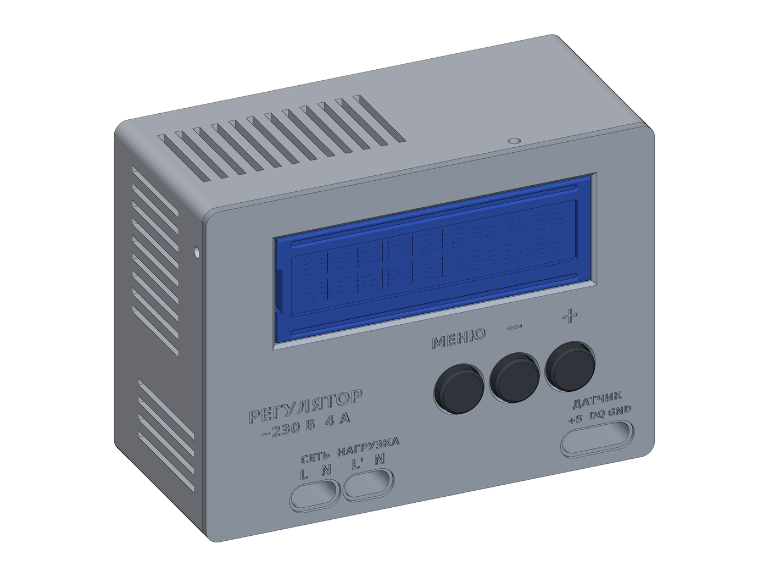
enclosure/build_4A/view_closed_above.png
