SamarGrigoriy/simistor-regulator/enclosure/build_4A/view_front.png

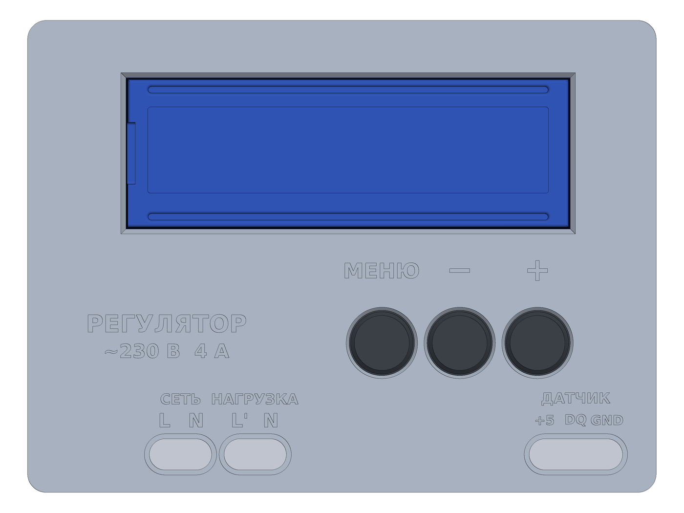
enclosure/build_4A/view_front.png
