SamarGrigoriy/simistor-regulator/enclosure/build_4A/view_inside_iso.png

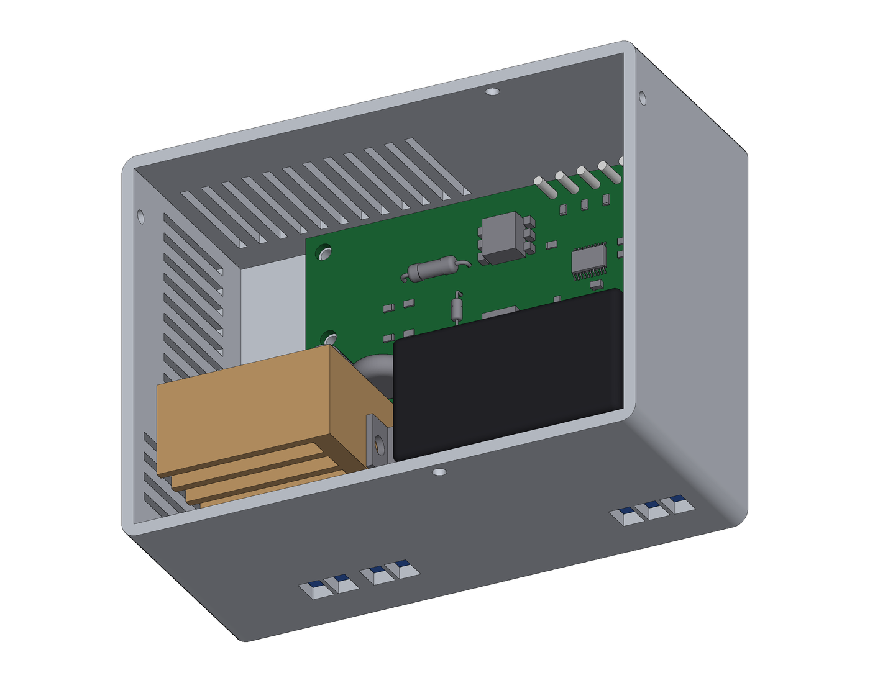
enclosure/build_4A/view_inside_iso.png
