SamarGrigoriy/simistor-regulator/enclosure/build_4A/view_inside_top.png

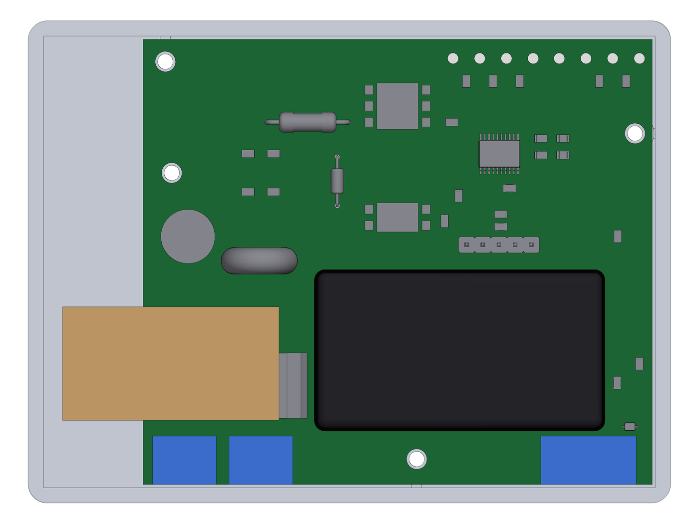
enclosure/build_4A/view_inside_top.png
