SamarGrigoriy/simistor-regulator/enclosure/build_4A/view_lid_inside.png

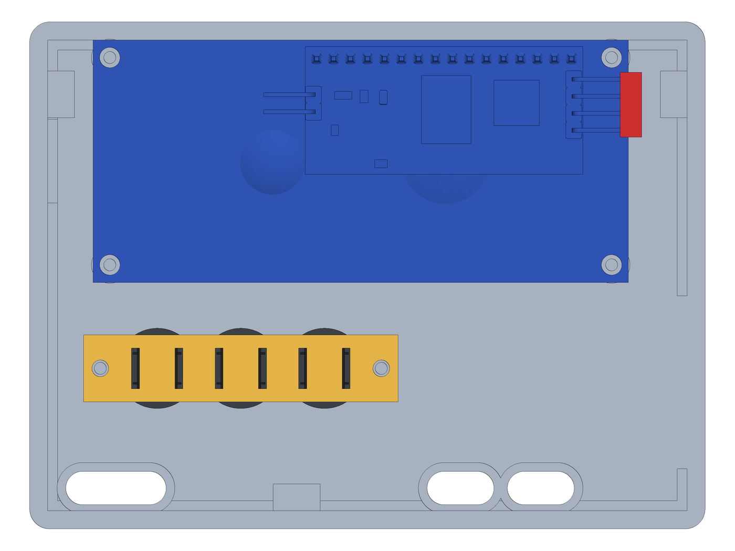
enclosure/build_4A/view_lid_inside.png
