SamarGrigoriy/simistor-regulator/enclosure/build_4A/view_open.png

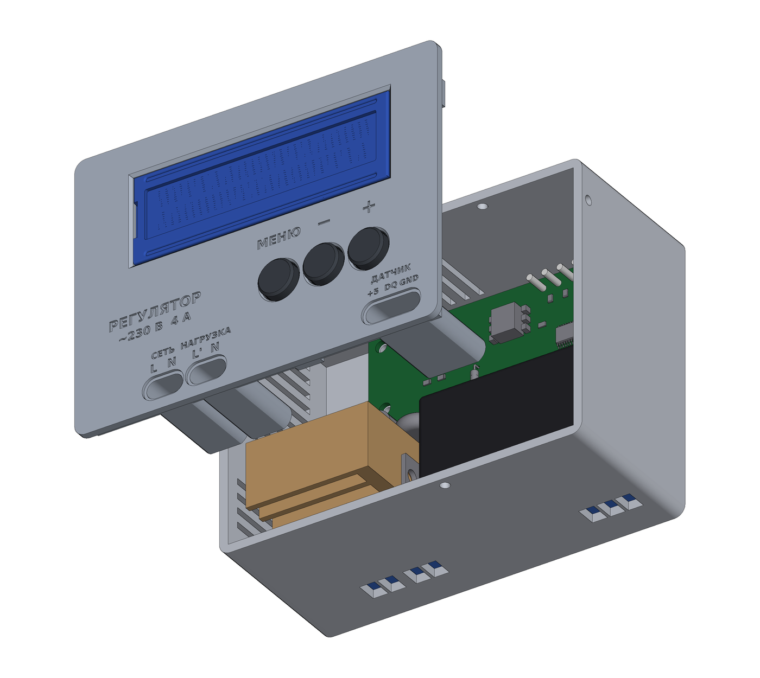
enclosure/build_4A/view_open.png
