SamarGrigoriy/simistor-regulator/enclosure/build_4A/view_section_lcd.png

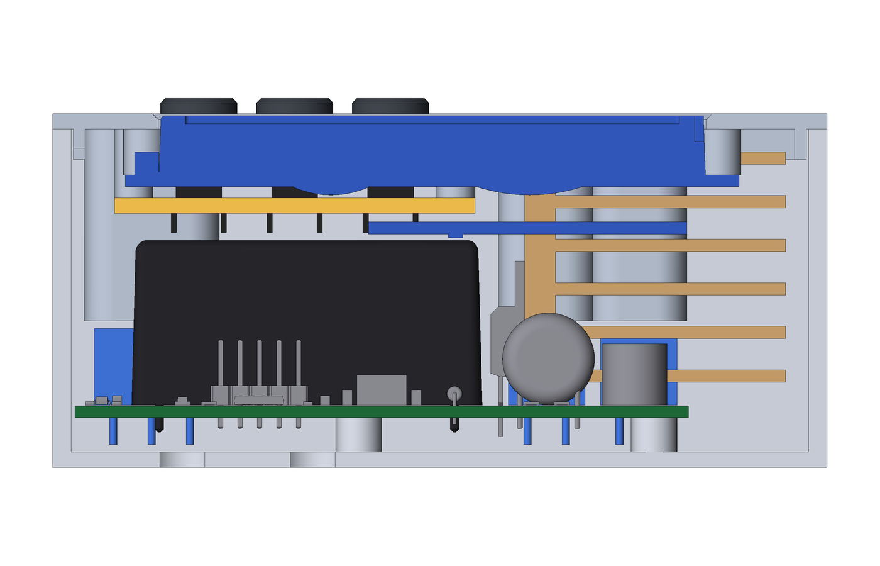
enclosure/build_4A/view_section_lcd.png
