SamarGrigoriy/simistor-regulator/enclosure/build_4A/view_section_triac.png

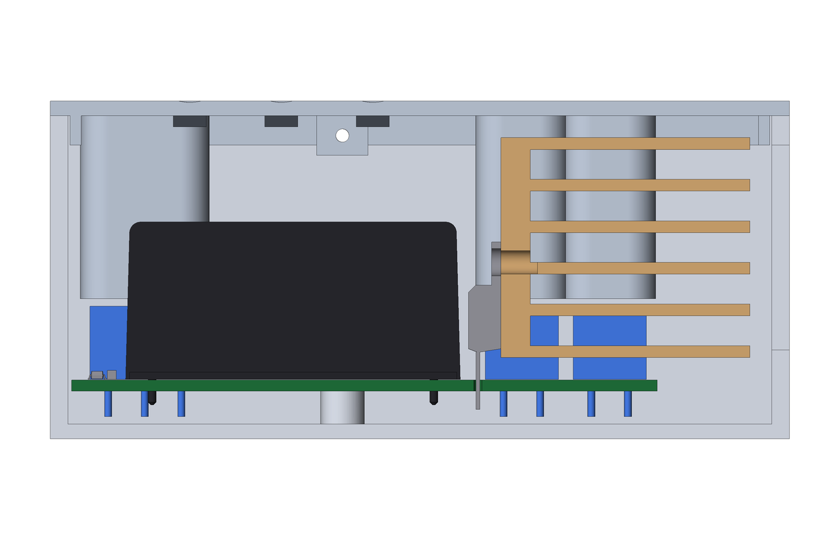
enclosure/build_4A/view_section_triac.png
