SamarGrigoriy/simistor-regulator/regulator1.kicad_pcb

## KiCad design regulator1.kicad_pcb (2026-10-23)

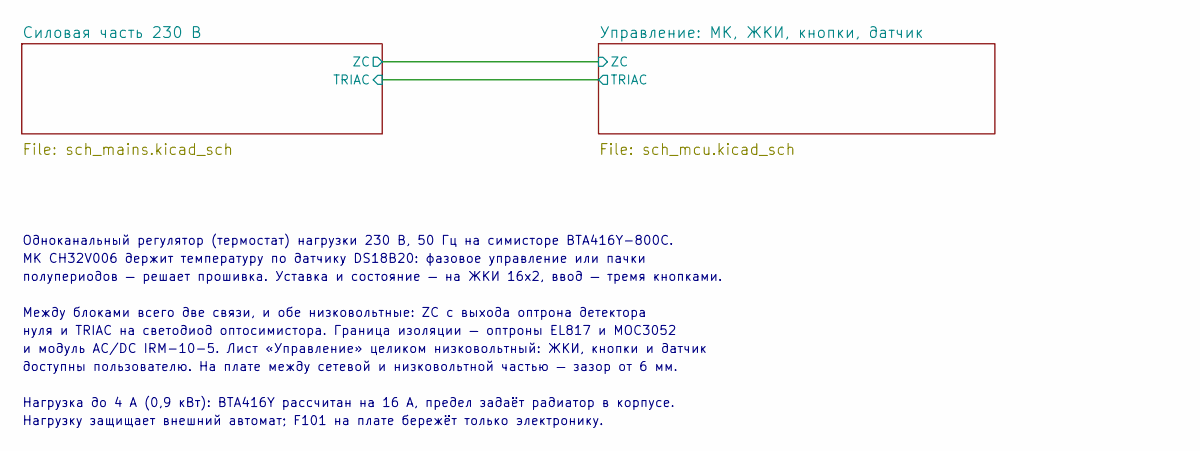
[picture p69: schematic regulator1.kicad_sch, Одноканальный симисторный регулятор]

Notes on the sheet:
Одноканальный регулятор (термостат) нагрузки 230 В, 50 Гц на симисторе BTA416Y-800C.
МК CH32V006 держит температуру по датчику DS18B20: фазовое управление или пачки
полупериодов — решает прошивка. Уставка и состояние — на ЖКИ 16x2, ввод — тремя кнопками.
Между блоками всего две связи, и обе низковольтные: ZC с выхода оптрона детектора
нуля и TRIAC на светодиод оптосимистора. Граница изоляции — оптроны EL817 и MOC3052
и модуль AC/DC IRM-10-5. Лист «Управление» целиком низковольтный: ЖКИ, кнопки и датчик
доступны пользователю. На плате между сетевой и низковольтной частью — зазор от 6 мм.
Нагрузка до 4 А (0,9 кВт): BTA416Y рассчитан на 16 А, предел задаёт радиатор в корпусе.
Нагрузку защищает внешний автомат; F101 на плате бережёт только электронику.

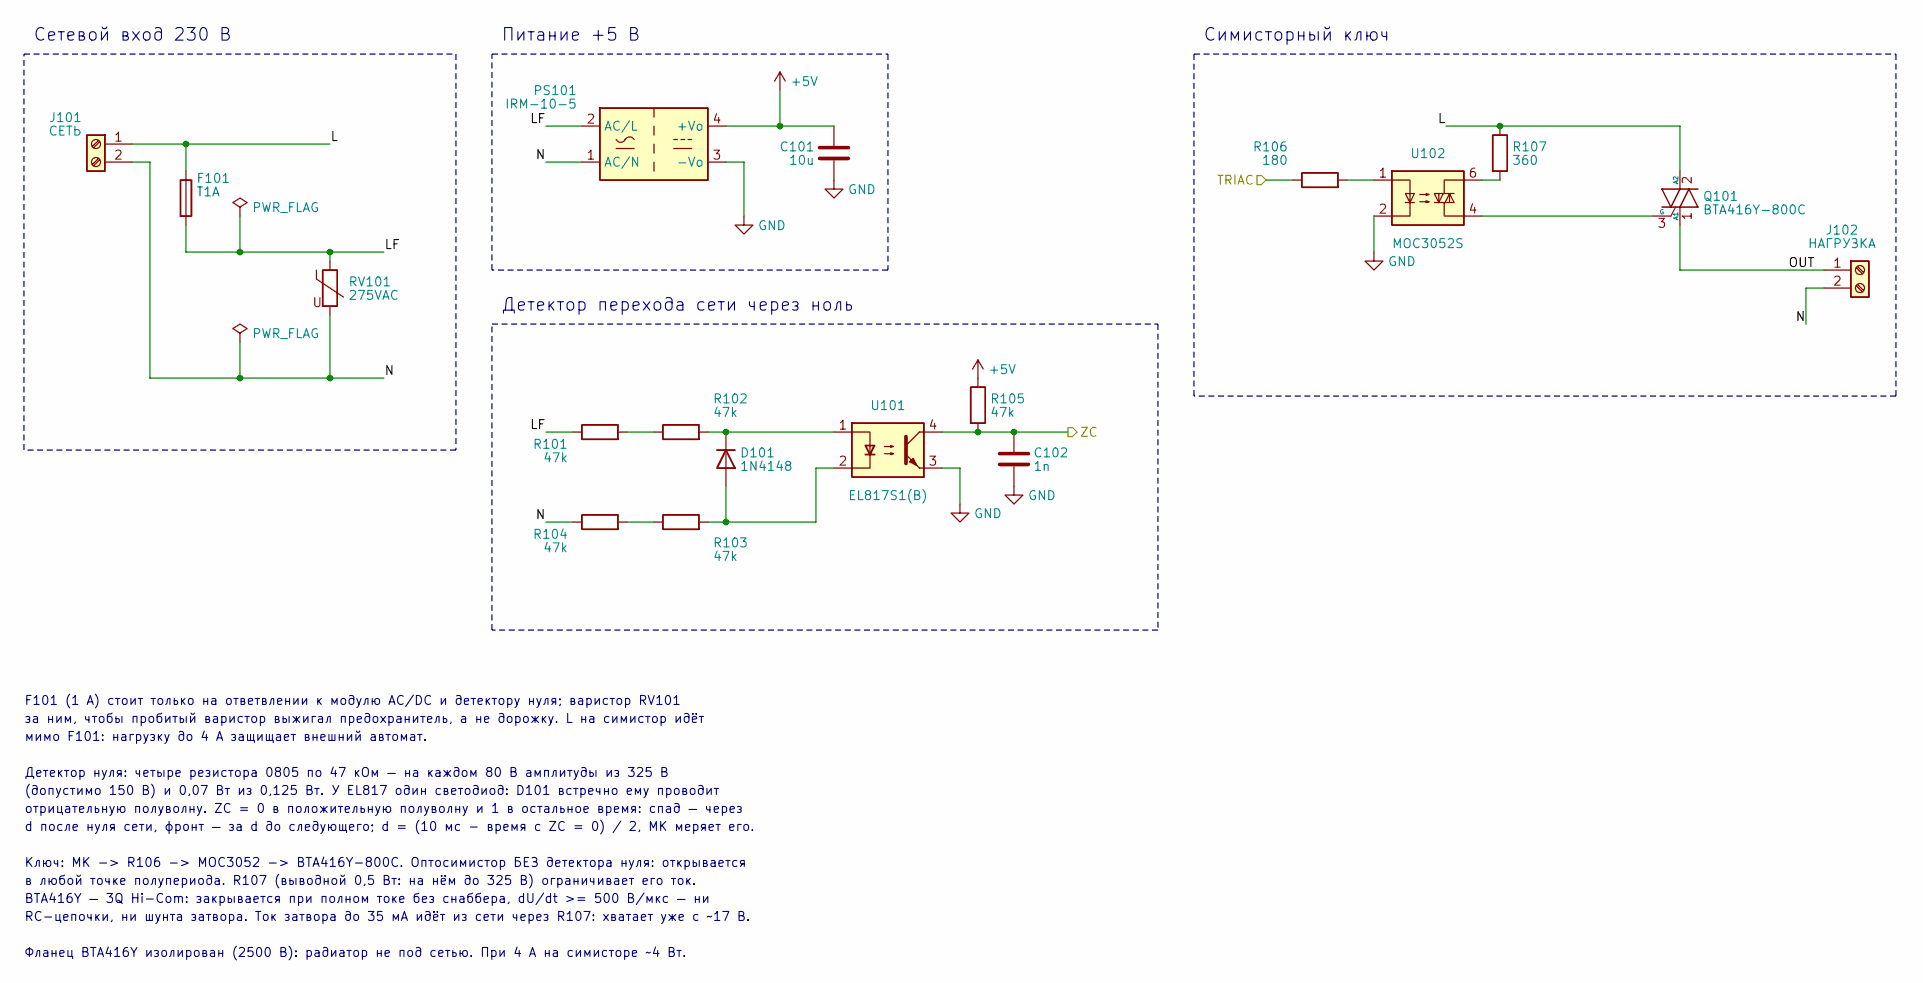
[picture p70: schematic sch_mains.kicad_sch, Силовая часть 230 В: питание, детектор нуля, ключ]

Parts:
C101: 10u; C_0805_2012Metric; MPN CL21A106KOQNNNE
C102: 1n; C_0805_2012Metric; MPN CC0805KRX7R9BB102
D101: 1N4148; D_DO-35_SOD27_P7.62mm_Horizontal; MPN 1N4148
F101: T1A; Fuse_Littelfuse_372_D8.50mm; MPN 37211000001
J101: СЕТЬ; TerminalBlock_Golten_GT301-5.0-02P_1x02_P5.00mm; MPN GT301-5.0-02P-12-00
J102: НАГРУЗКА; TerminalBlock_Golten_GT301-5.0-02P_1x02_P5.00mm; MPN GT301-5.0-02P-12-00
PS101: IRM-10-5; Converter_ACDC_MeanWell_IRM-10-xx_THT; MPN IRM-10-5
Q101: BTA416Y-800C; TO-220-3_Vertical; MPN BTA416Y-800C,127
R101, R102, R103, R104, R105: 47k; R_0805_2012Metric; MPN RC0805FR-0747KL
R106: 180; R_0805_2012Metric; MPN RC0805JR-07180RL
R107: 360; R_Axial_DIN0309_L9.0mm_D3.2mm_P12.70mm_Horizontal; MPN MFR-50JT-52-360R
RV101: 275VAC; RV_Disc_D12mm_W4.2mm_P7.5mm; MPN TSV10D431K
U101: EL817S1(B); SMDIP-4_W9.00mm_Everlight-EL817-S1; MPN EL817S1(B)(TU)-F
U102: MOC3052S; SMDIP-6_W9.00mm_LiteOn-MOC305xS; MPN MOC3052S-TA1

Connections:
+5V: C101.1, PS101.4 (+Vo), R105.1; also elsewhere on the board
/Силовая часть 230 В/L: F101.1, J101.1, Q101.2 (A2), R107.1
/Силовая часть 230 В/LF: F101.2, PS101.2 (AC/L), R101.1, RV101.1
/Силовая часть 230 В/N: J101.2, J102.2, PS101.1 (AC/N), R104.1, RV101.2
/Силовая часть 230 В/OUT: J102.1, Q101.1 (A1)
/Силовая часть 230 В/TRIAC: R106.1; also elsewhere on the board
/Силовая часть 230 В/ZC: C102.1, R105.2, U101.4; also elsewhere on the board
GND: C101.2, C102.2, PS101.3 (-Vo), U101.3, U102.2; also elsewhere on the board
unnamed: D101.2 (A), R103.2, U101.2
unnamed: D101.1 (K), R102.2, U101.1
unnamed: Q101.3 (G), U102.4
unnamed: R101.2, R102.1
unnamed: R103.1, R104.2
unnamed: R106.2, U102.1
unnamed: R107.2, U102.6

Notes on the sheet:
Сетевой вход 230 В
Питание +5 В
Детектор перехода сети через ноль
Симисторный ключ
F101 (1 А) стоит только на ответвлении к модулю AC/DC и детектору нуля; варистор RV101
за ним, чтобы пробитый варистор выжигал предохранитель, а не дорожку. L на симистор идёт
мимо F101: нагрузку до 4 А защищает внешний автомат.
Детектор нуля: четыре резистора 0805 по 47 кОм — на каждом 80 В амплитуды из 325 В
(допустимо 150 В) и 0,07 Вт из 0,125 Вт. У EL817 один светодиод: D101 встречно ему проводит
отрицательную полуволну. ZC = 0 в положительную полуволну и 1 в остальное время: спад — через
d после нуля сети, фронт — за d до следующего; d = (10 мс - время с ZC = 0) / 2, МК меряет его.
Ключ: МК -> R106 -> MOC3052 -> BTA416Y-800C. Оптосимистор БЕЗ детектора нуля: открывается
в любой точке полупериода. R107 (выводной 0,5 Вт: на нём до 325 В) ограничивает его ток.
BTA416Y — 3Q Hi-Com: закрывается при полном токе без снаббера, dU/dt >= 500 В/мкс — ни
RC-цепочки, ни шунта затвора. Ток затвора до 35 мА идёт из сети через R107: хватает уже с ~17 В.
Фланец BTA416Y изолирован (2500 В): радиатор не под сетью. При 4 А на симисторе ~4 Вт.

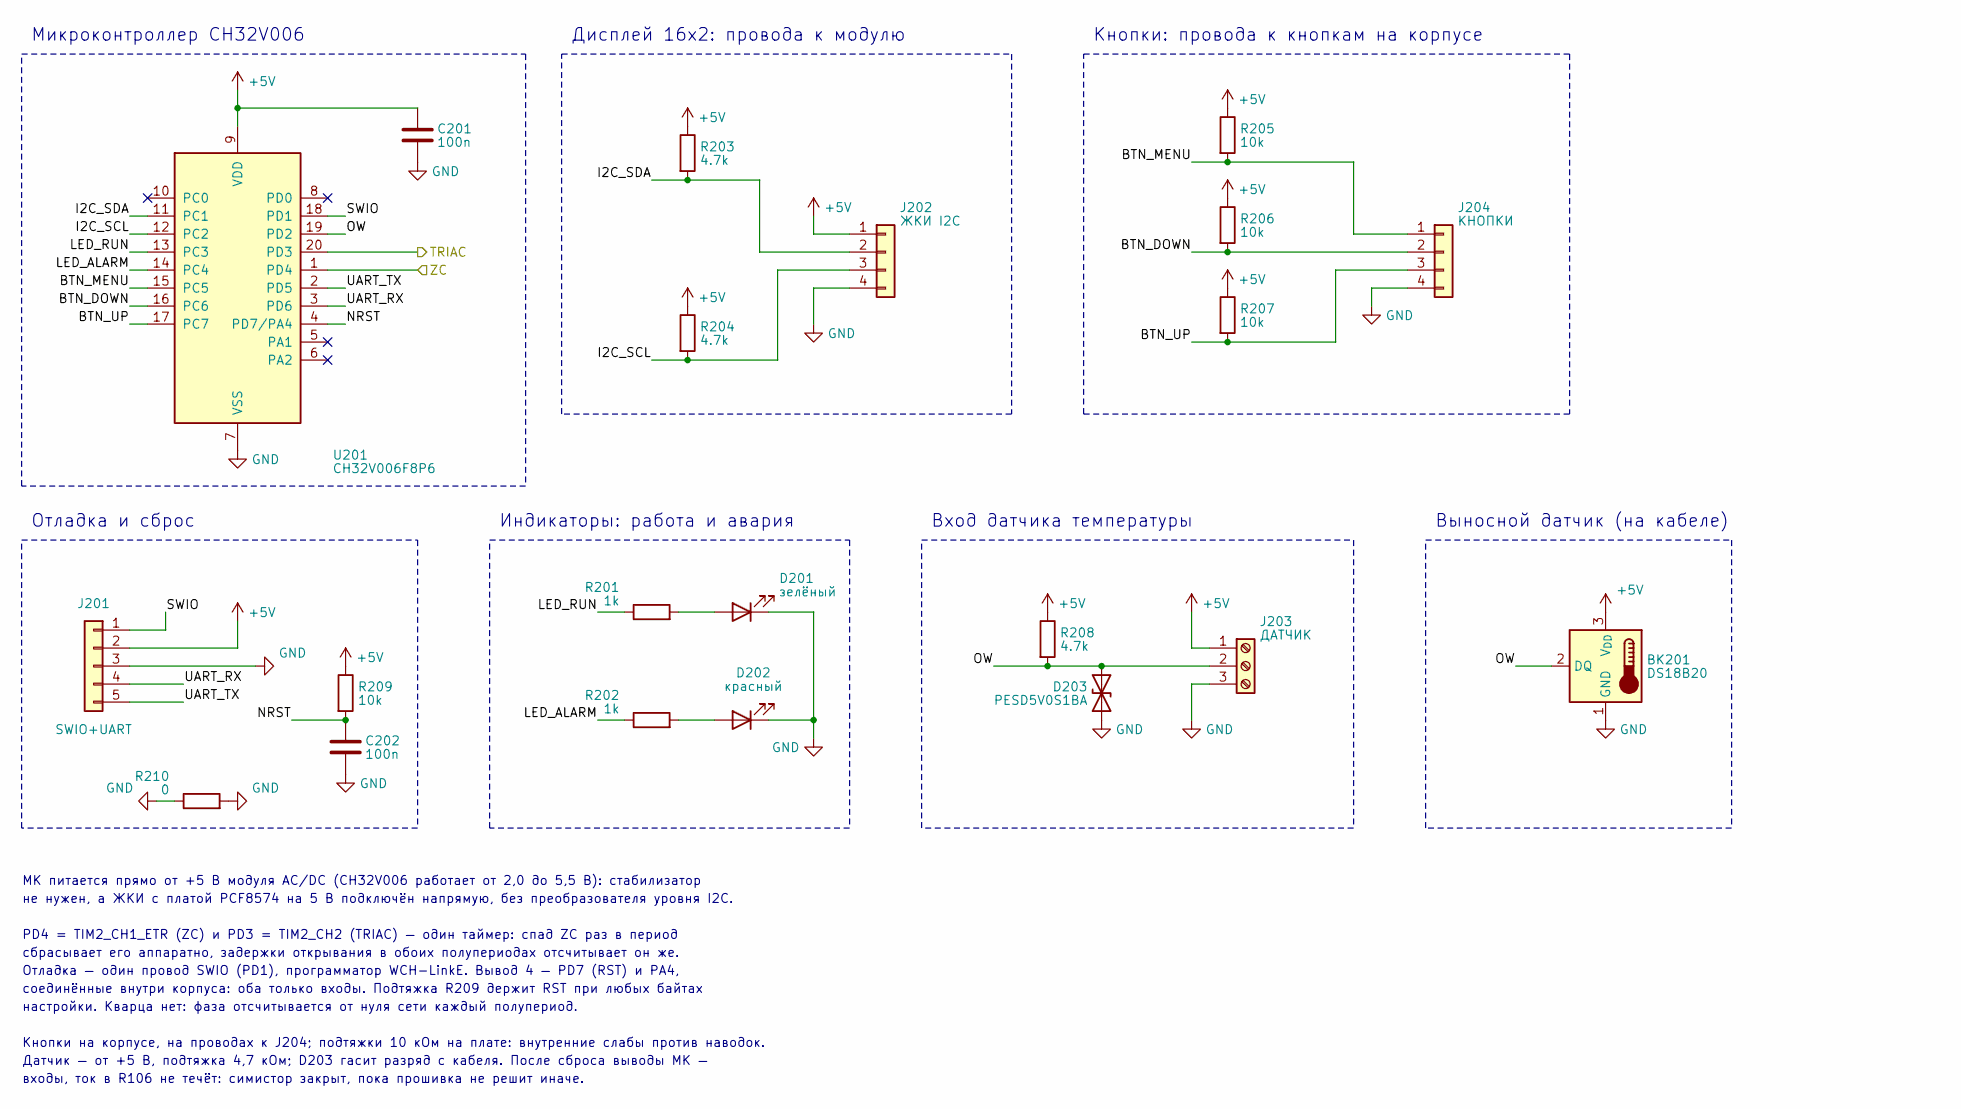
[picture p71: schematic sch_mcu.kicad_sch, Управление: CH32V006, ЖКИ, кнопки, датчик]

Parts:
BK201: DS18B20; MPN DS18B20 WATERPROOF TEMPERATURE SENSOR
C201, C202: 100n; C_0805_2012Metric; MPN CL21B104KBCNNNC
D201: зелёный; LED_0805_2012Metric; MPN LTST-C170KGKT
D202: красный; LED_0805_2012Metric; MPN LTST-C170KRKT
D203: PESD5V0S1BA; D_SOD-323; MPN PESD5V0S1BA,115
J201: SWIO+UART; PinHeader_1x05_P2.54mm_Vertical; MPN DS1021-1X5SF11-B
J202: ЖКИ I2C; SolderWire-0.25sqmm_1x04_P4.2mm_D0.65mm_OD1.7mm
J203: ДАТЧИК; TerminalBlock_Golten_GT301-5.0-03P_1x03_P5.00mm; MPN GT301-5.0-03P-12-00
J204: КНОПКИ; SolderWire-0.25sqmm_1x04_P4.2mm_D0.65mm_OD1.7mm
R201, R202: 1k; R_0805_2012Metric; MPN RC0805FR-071KL
R203, R204, R208: 4.7k; R_0805_2012Metric; MPN RC0805FR-074K7L
R205, R206, R207, R209: 10k; R_0805_2012Metric; MPN RC0805FR-0710KL
R210: 0; R_0805_2012Metric; MPN RC0805FR-070RL
U201: CH32V006F8P6; TSSOP-20_4.4x6.5mm_P0.65mm; MPN CH32V006F8P6; LCSC C52753342

Connections:
+5V: BK201.3 (V_{DD}), C201.1, J201.2, J202.1, J203.1, R203.1, R204.1, R205.1, R206.1, R207.1, R208.1, R209.1, U201.9 (VDD); also elsewhere on the board
/Силовая часть 230 В/TRIAC: U201.20 (PD3); also elsewhere on the board
/Силовая часть 230 В/ZC: U201.1 (PD4); also elsewhere on the board
/Управление: МК, ЖКИ, кнопки, датчик/BTN_DOWN: J204.2, R206.2, U201.16 (PC6)
/Управление: МК, ЖКИ, кнопки, датчик/BTN_MENU: J204.1, R205.2, U201.15 (PC5)
/Управление: МК, ЖКИ, кнопки, датчик/BTN_UP: J204.3, R207.2, U201.17 (PC7)
/Управление: МК, ЖКИ, кнопки, датчик/I2C_SCL: J202.3, R204.2, U201.12 (PC2)
/Управление: МК, ЖКИ, кнопки, датчик/I2C_SDA: J202.2, R203.2, U201.11 (PC1)
/Управление: МК, ЖКИ, кнопки, датчик/LED_ALARM: R202.1, U201.14 (PC4)
/Управление: МК, ЖКИ, кнопки, датчик/LED_RUN: R201.1, U201.13 (PC3)
/Управление: МК, ЖКИ, кнопки, датчик/NRST: C202.1, R209.2, U201.4 (PD7/PA4)
/Управление: МК, ЖКИ, кнопки, датчик/OW: BK201.2 (DQ), D203.2 (A2), J203.2, R208.2, U201.19 (PD2)
/Управление: МК, ЖКИ, кнопки, датчик/SWIO: J201.1, U201.18 (PD1)
/Управление: МК, ЖКИ, кнопки, датчик/UART_RX: J201.4, U201.3 (PD6)
/Управление: МК, ЖКИ, кнопки, датчик/UART_TX: J201.5, U201.2 (PD5)
GND: BK201.1 (GND), C201.2, C202.2, D201.1 (K), D202.1 (K), D203.1 (A1), J201.3, J202.4, J203.3, J204.4, R210.1, R210.2, U201.7 (VSS); also elsewhere on the board
unnamed: D201.2 (A), R201.2
unnamed: D202.2 (A), R202.2

Notes on the sheet:
Микроконтроллер CH32V006
Дисплей 16x2: провода к модулю
Кнопки: провода к кнопкам на корпусе
Отладка и сброс
Индикаторы: работа и авария
Вход датчика температуры
Выносной датчик (на кабеле)
МК питается прямо от +5 В модуля AC/DC (CH32V006 работает от 2,0 до 5,5 В): стабилизатор
не нужен, а ЖКИ с платой PCF8574 на 5 В подключён напрямую, без преобразователя уровня I2C.
PD4 = TIM2_CH1_ETR (ZC) и PD3 = TIM2_CH2 (TRIAC) — один таймер: спад ZC раз в период
сбрасывает его аппаратно, задержки открывания в обоих полупериодах отсчитывает он же.
Отладка — один провод SWIO (PD1), программатор WCH-LinkE. Вывод 4 — PD7 (RST) и PA4,
соединённые внутри корпуса: оба только входы. Подтяжка R209 держит RST при любых байтах
настройки. Кварца нет: фаза отсчитывается от нуля сети каждый полупериод.
Кнопки на корпусе, на проводах к J204; подтяжки 10 кОм на плате: внутренние слабы против наводок.
Датчик — от +5 В, подтяжка 4,7 кОм; D203 гасит разряд с кабеля. После сброса выводы МК —
входы, ток в R106 не течёт: симистор закрыт, пока прошивка не решит иначе.

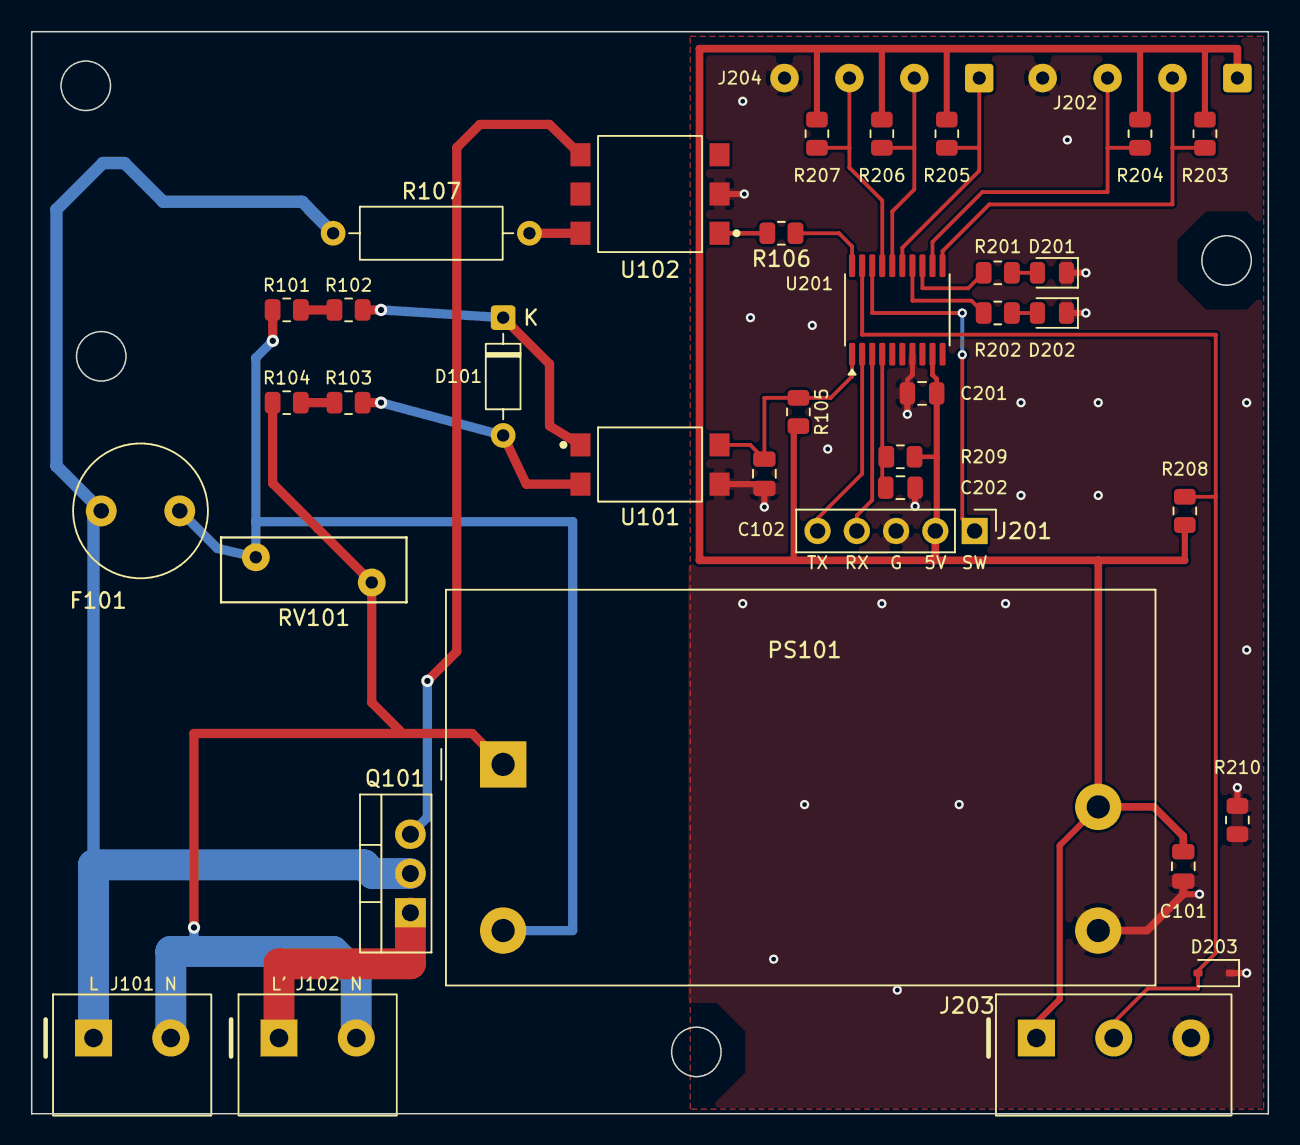
[picture p72: board regulator1.kicad_pcb from above]

Board: 2 copper layers, 80.0 x 70.0 mm, 38 parts (0 on the bottom side), 29 nets.
